Husseinbeygi/CUED-Self-Balancing-Bike/Reports/Final Report/sections/Introduction.tex

\begin{figure}[H]
	\centering
    \def\svgwidth{0.9\textwidth}
    \input{./figures/bikeevo.pdf_tex}
    \caption{Bicycle Evolution (adapted from \cite{bikeevo})}
	\label{fig:bikeevo}
\end{figure}

Bicycles and their stability properties have been studied for well over a century, most notably by academics such as Whipple (1899, \cite{whipple}), Papadopoulos (1980s onwards, \cite{papadopoulos}), and {\AA}str{\"o}m (2005, \cite{astrom}). The bicycle is a naturally unstable system but can be self-stable under certain conditions. It is however still commonly unclear what primarily contributes to this self-stability. The full form of the equations of motion do not aid the intuitive understanding of bicycle stability and dynamics, as they are a set of coupled and highly non-linear differential equations. \\

\noindent In addition to simply understanding the causes of self-stability , there are further considerations to studying a bicycle in the frameworks of dynamics and control theory. For example, how does a human stabilise a bicycle and is it possible to replicate this behaviour with motors? What makes a bike more or less stable - for instance, changes in geometry, mass distribution, or wheel size? And would there be a benefit in having an assisted bicycle for certain people in certain situations? \\

\noindent This project aims to answer - at least in part - some of these questions. In addition, this project explores the modelling, simulation, control system design, and implementation of two rider-less, self-balancing bicycles. \\

The first bicycle was chosen to be a \textit{Lego Mindstorms} prototype and the second one a full-scale, adult bicycle. Both bicycles are depicted in Figures \ref{fig:lego} and \ref{fig:fs} below in their final, modified forms. These bicycles however only have a drive actuator, to provide forward velocity, and an actuator placed at the handlebars to provide a \textit{steer} torque. Without the additional component of being able to provide a \textit{lean} torque, it is extremely difficult to guarantee stability at near-zero forward speed, as will be shown in this report. The bicycles being studied in this case can therefore be classed as \textit{underactuated systems}.

\vfill

\begin{figure}[h]
\centering

\caption{Lego Prototype Bicycle}
\label{fig:lego}
\end{figure}

\begin{figure}[h]
\centering

\caption{Full-Scale Bicycle}
\label{fig:fs}
\end{figure}

\newpage
