Husseinbeygi/CUED-Self-Balancing-Bike/Reports/Scribble.pdf

# Self-Balancing Bicycle

## Final Project

Philip Salmony
Wolfson College
pms67@cam.ac.uk

Supervisor: Dr. Fulvio Forni

4 September 2018

## Summary

Modelling, analysis, simulation, and implementation of an autonomous, self-balancing bicycle.

## Contents

1 Introduction and Objectives | 3
2 Notation | 3
3 Bicycle Modelling | 3
4 Equations of Motion | 5
5 Controller Design | 8
6 Trajectory Tracking | 12
7 Simulation | 12
8 Implementation | 12
9 Results and Discussion | 13
10 Conclusions | 13
11 References | 13
12 Appendix | 13

## 1 Introduction and Objectives

1. Autonomous self-balancing at close-to-zero forward velocity and above.
2. Robustness to modelling inaccuracies as well as to mass and geometry changes.
3. Trajectory tracking.

## 2 Notation

Coordinate systems, notation(e.g. mrf , Ixx, etc..)

## 3 Bicycle Modelling


Figure 1: Simplified Bike Model and Coordinate System

### 3.1 Mass and Center of Mass

The purchased bike was disassembled and the masses of both wheels and the remaining frame measured using a luggage scale. To estimate the masses of the rear and front frames, the dimensions of each connecting tube of the frames was measured to approximate their respective volumes. As mass is proportional to volume, this enabled an estimate of the individual masses of the tubes. Summing the tubes belonging to the appropriate frame gave an approximation of the mass of that frame. The results are as follows:

- mrf = 7.8kg
- mf f = 2.1kg
- mrw = 3.1kg
- mfw = 2.5kg

Rear Frame
(x, y, z)rf = [0.507, 0.000, −0.534]

Front Frame
(x, y, z)f f = [0.960, 0.000, −0.597]

Rear Wheel
(x, y, z)rw = [0.000, 0.000, −0.320]

Front Wheel
(x, y, z)f f = [1.080, 0.000, −0.320]

### 3.2 Inertia Tensor

The moment of inertia tensor describes the resistance to rotational motion of a three-dimensional object around certain axes about its center of mass. It is defined as follows,

I =

Ixx Ixy Ixz
Iyx Iyy | Iyz
Izx Izy | Izz

We make the simplifying assumption that the terms Ixz, Izx, Iyz, Izy are zero. The defini-tions for the remaining terms are,

Ixx =

Z
(y

2 + z

2
)dm

Iyy =

Z
(x

2 + z

2
)dm

Izz = Ixx + Iyy

Ixy = Iyx = −

Z
(x · y)dm

Rear Frame

Irf =

0.206 | 0 | 0.164
0 | 0.643 | 0
0.164 | 0 | 0.444

Front Frame

Iff =

0.061 | 0 | −0.017
0 | 0.059 | 0
−0.017 | 0 | 0.013

Rear Wheel

Irw =

0.159 | 0 | 0
0 | 0.317 | 0
0 | 0 | 0.159

Front Wheel

Ifw =

0.128 | 0 | 0
0 | 0.256 | 0
0 | 0 | 0.128

### 3.3 Overall Description

Total System

Mass and Center of Mass

mt = mrw + mrf + mf f + mfw = 15.5 | (1)

xt =

1
mt
(xrfmrf + xf fmf f + wmfw) = 0.559 | (2)

zt =

1
mt
(−Rrwmrw + zrfmrf + zf fmf f − Rfwmfw) = −0.465 | (3)

Moments and Products of Inertia

Txx = Axx + Bxx + Cxx + Dxx + mrwR

2
rw + mrf z

2
rf + mf f z

2
f f + mfwR

2
fw = 4.10 | (4)
Txz = Bxz + Cxz − mrfxrf zrf − mf fxf f zf f + mfwwRfw = 4.33 | (5)

Tzz = Azz + Bzz + Czz + Dzz + mrfx

2
rf + mf fx

2
f f + mfww
2 = 7.60 | (6)

Front Frame

Mass and Center of Mass

mf = mf f + mfw = 4.6 | (7)

xf =

1
mf
(xf fmf f + wmfw) = 1.025 | (8)

zf =

1
mf
(zf fmf f − Rfwmfw) = −0.446 | (9)

Moments and Products of Inertia

Fxx = Cxx + Dxx + mf f (zf f − zf )

2 + mfw(Rfw + zf )

2 = 0.277 | (10)
Fxz = Cxz − mf f (xf f − xf )(zf f − zf ) + mfw(w − xf )(Rfw + zf ) = −0.0549 | (11)

Fzz = Czz + Dzz + mf f (xf f − xf )

2 + mfw(w − xf )

2 = 0.157 | (12)

Miscellaneous

λ =

π
2

− α =

π
9

(13)

u = (xf − w − t) · cos(λ) − zf · sin(λ) = 0.021 | (14)

Sr =

Ayy

Rrw

= 0.991, Sf =

Dyy
Rfw
= 0.800, St = Sr + Sf = 1.79 | (15)

## 4 Equations of Motion

### 4.1 Second Order Model

### 4.1.1 Excluding Fork Dynamics

Simplified tilt equation:

¨θ =

Mgl
J

sin(θ) + Ml
J

v

2
r
b

tan(φ) + a
b

d(vtan(φ))
dt
cos(θ) | (16)

For near-upright motion with constant velocity v: ˙v = 0, sin(θ) ≈ θ, tan(φ) ≈ φ, and cos(θ) ≈ 1. We can therefore linearise the equation as follows:

¨θ =

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
(17)

Defining γ =

M l
Jb :

¨θ = bgγθ + γ(v
2

rφ + avφ˙)

Taking Laplace transforms:

s

2 ¯θ = bgγ ¯θ + γ(v
2

rφ¯ + savφ¯)

¯θ(s

2 − bgγ) = φγv ¯ (sa + v)

Which results in the transfer function G(s) from steer angle φ to lean angle θ:

G(s) = γva

(s +

v
a

)
(s

2 − bgγ)

(18)

We can extract three bits of information:

1. Gain: k =

M lva
Jb
2. Zero: z = −

v
a
3. Poles: p1,2 = ±

q
M lg
J

The gain tells us that as our forward velocity v goes to zero, turning the forks will not influence the tilt angle.
The zero tells us that this is a minimum phase system.
The poles tell us that this system is unstable and non-oscillatory.

For the prototype bicycle the transfer function becomes,

G(s) = 0.491 · v ·

(s +

v
0.559 )
(s
2 − 9.30). | (19)

### 4.1.2 Including Fork Dynamics

Shows stability for large enough forward speed...

### 4.2 Fourth Order Model

A model found in many research papers, is the fourth order linearised model consisting of two coupled second order differential equations. This model can be written in the following matrix form:

M · q¨+ [C1 · v] · q˙ + [K0 + K2 · v

2
] · q = f | (20)

Where q = [φ, δ]

T
is a vector containing the lean angle (φ) and the steer angle (δ), f = [Tφ, Tδ]

T
is a vector consisting of a roll torque disturbance and handlebar torque, and finally the system matrices, which are derived from the bicycle geometry:
1. M - Mass matrix
2. C1 - Damping matrix, varying linearly with velocity
3. K0 and K2 - Stiffness matrices, varying quadratically with velocity

The elements of each matrix are as follows:

M =

Txx | Fλx + fTxz
Fλx + fTxz | Fλλ + 2fFλz + f

2Tzz
(21)

C1 =

"
0 | fSt + Sf cos(λ) + Txz

cos(λ)
w | − fmtzt
−(fSt + Sf cos(λ)) | Fλz

λ
w + f(Su + Tzz

cos(λ)
w
(22)

K0 =

gmtzt | −gSu
−gSu | −gSusin(λ)
(23)

K2 =

"
0 (St − mtzt)

cos(λ)
w
0 (Su + Sf sin(λ)) cos(λ)
w
(24)

### 4.2.1 Decoupling and Transfer Functions

Taking Laplace Transforms, assuming zero initial conditions:

s

2
- M · q¯+ s · [C1 · v] · q¯+ [K0 + K2 · v

2

] · q¯ = ¯f

Rearranging into transfer function form yields:

G(s) =
s

2
- M + s · C1 · v + (K0 + K2 · v

2
)

−1
(25)

Since K211 = K221 = C111 = 0, the determinant of G(s) is

det(G(s)) = P(s) = s

4
- (M11M22 − M12M21)

+ s

3
- v · (M11C122 − (M12C121 + M21C112 )

+ s

2
- (M11K022 + M22K011 − M21K012 − M12K021 ) + v

2
- (M11K222 − M21K212 − C112C121 ))

+ s · v · (K011C122 − K021C112 − K012C121 − v

2
- K212C121 )

+ (K011K022 − K021K012 ) + v

2
- (K011K222 − K021K212 ).

Where the roots of P(s) are equal to the poles of the system.

As can be seen from the long expression above, it is hard to directly see what parameters in the bicycle’s geometry - or the forward speed - influence the stability. This is especially true, since this is a linearised model of a much more complex system!

Continuing with the evaluation of the matrix inverse, we get a set of four decoupled transfer functions relating the roll and steer torque inputs to the roll and steer angular outputs:

(i) Roll Torque Disturbance to Lean Angle

G11(s) = m22 · s

2 + v · C122 · s + (K022 + K222 · v

2
)
P(s)

(ii) Roll Torque Disturbance to Steer Angle

G12(s) = −

m12 · s

2 + v · C112 · s + (K012 + K212 · v

2
)
P(s)

(iii) Handlebar Torque to Lean Angle

G21(s) = −

m21 · s

2 + v · C121 · s + K021
P(s)

(iv) Handlebar Torque to Steer Angle

G22(s) = m11 · s

2 + K011
P(s)

Again, it is hard to see how the bicycle parameters influence the positions of the systems zeros.

For the prototype bicycle the poles P(s) are then given by,

P(s) = 0.711s

4 + 1.30vs³ + s

2
(−22.3 + 5.01v

2
) + sv(−21.4 + 6.93v

2
) + (123 − 5.54v

2
) (26)

Which leads to following the set of transfer functions:

(i) Roll Torque Disturbance to Lean Angle

G11(s) = 0.214 · s

2 + v · 0.744 · s + (−2.48 + 0.881 · v

2
)
P(s)

(27)

(ii) Roll Torque Disturbance to Steer Angle

G12(s) = −

0.407 · s

2 + v · 5.18 · s + (−7.25 + 7.83 · v

2
)
P(s)

(28)

(iii) Handlebar Torque to Lean Angle

G21(s) = −

0.407 · s

2 − 0.884 · v · s − 7.25
P(s)

(29)

(iv) Handlebar Torque to Steer Angle

G22(s) = 4.10 · s

2 − 70.7
P(s)

(30)

### 4.3 State Space Form

Choosing states as x =

φ δ φ˙ ˙δ

T
and inputs as u =
Tφ Tδ

T
, we arrive at the
following state space model for our prototype bicycyle (assuming all our states are measur-able):

x˙ = Ax + Bu
y = Cx

With the system matrices being,

A =

0 | 0 | 1 | 0
0 | 0 | 0 | 1
17.1 0.761 − 1.85v

2 −0.506v −1.13v
1.36 10.2 − 0.602v
2 | 5.10v | −1.32v

B =

0 | 0
0 | 0
0.300 | −0.572
−0.572 | 5.77

C =

1 0 0 0
0 1 0 0
0 0 1 0
0 0 0 1

(31)

## 5 Controller Design

What can we actuate? What sensor do we have? Controllability/Observability

### 5.1 Stability Analysis

### 5.1.1 Dependence on Forward Speed

Three controller regimes.

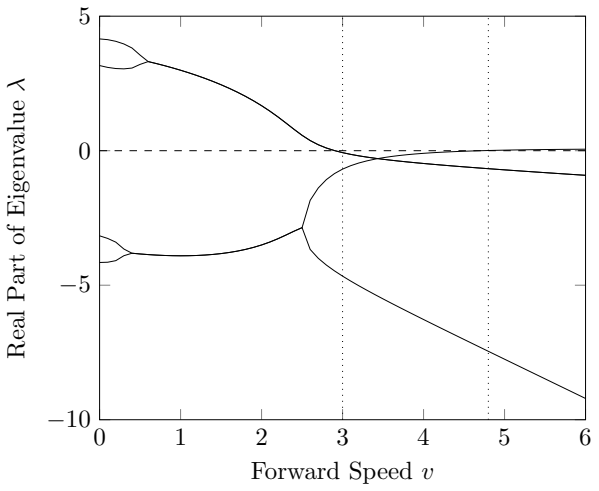
[picture p13: figure]
Forward Speed v; Real Part of Eigenvalue

Figure 2: Pole Locations vs Forward Speed

### 5.2 Single Input Single Output (SISO)

CURRENTLY EXCLUDING FORK DYNAMICS - WILL CHANGE Which transfer function model do we use? Second order, fourth order, or both? BOTH

### 5.2.1 Proportional Controller

Kp | G(s) r¯ | e¯ | u¯ | y¯

y¯m

Figure 3: P Controller Structure

Transfer Function
Plotting the root locus diagram for the tilt transfer function, we can see that a simple proportional controller (K(s) = Kp) in a standard negative feedback configuration can stabilise this plant. The closed-loop transfer function P(s) is of the following form:

P(s) = Kp · (γva) ·

(s +

v
a

)
s

2 + (γva)Kps + γ(v

2
rKp − bg)

(32)

Using the following root locus relationship to find the required proportional gain:

Kp =

1
|G(s)|

(33)

We are concerned with finding the minimum proportional gain that will guarantee closed-loop stability, therefore we wish to find a gain that will give us s < 0. Therefore, at s = 0, Kp =

bg
v

2
r

, which is the proportional gain needed for marginal stability. We require a gain larger than this to ensure asymptotic stability.

The furthest left we can go in the s-plane by increasing Kp is when our closed-loop pole meets the open-loop zero at v
a

, which gives an exponential decay time constant of a
v

Prototype Bicycle
For the prototype bicycle, the closed-loop transfer function with a proportional controller becomes,

P(s) = 0.491 · Kp · v ·

(s +

v
0.559 )
s

2 + 0.491 · Kp · v · s + 0.878 · (v

2Kp − 10.6). | (34)

From above, we require a minimum proportional gain of Kp =

bg
v

2 =

10.6
v

2 for stability.

### 5.2.2 P-D Controller

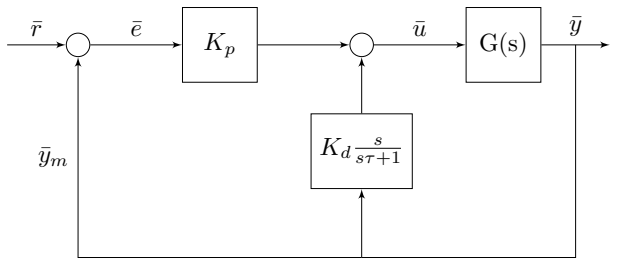
[picture p14: figure]

Figure 4: P-D Controller Structure

Derivative on measurement to avoid derivative kick when setpoint changes.

Derivative on Measurement
e = r - y
u = Kp * e - Kd * s / (sT + 1) * y y = G * u

Band-Limited Differentiator
Since a pure differentiator acts as an amplifier for high frequencies, it will also amplify any high-frequency noise present in the measured plant output. Additionally, for a low sample time, this amplification increases by 1
T

. This will result in extreme jittering of the actuator, drastically reducing its lifespan and the overall control performance. Furthermore, we cannot calculate the exact derivative at time t. We need to approximate it numerically, for example, using Euler’s backward difference method.
To address these problems, instead of implementing a pure derivative controller with transfer function s, we utilize a band-limited differentiator. This is effectively a pure differentiator cascaded with a single-pole low-pass filter,

D(s) = Kd

s
sτ + 1
, | τ > 0. | (35)

Where Kd is the associated derivative gain and τ is the filter time constant. The cut-off frequency (in rads⁻¹
) of the low-pass filter is therefore 1
| τ

. The closer τ is to zero, the closer our approximation is to the actual derivative. However, we will also greatly increase our noise since this is inversely proportional to the cut-off frequency of the filter.

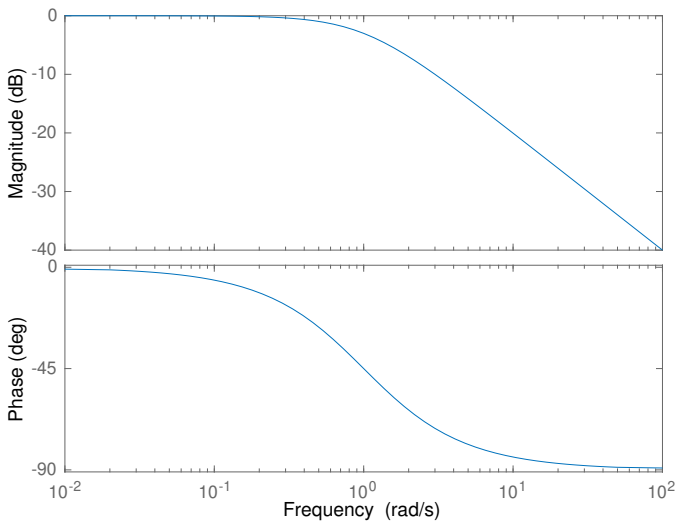
[picture p15: figure]
Magnitude (dB); Phase (deg); Frequency (rad/s)

Figure 5: Bode Diagram of Band-Limited Differentiator (τ = 1)

Transfer Function
The closed-loop transfer function of the P-D controller in combination with a general plant G(s) is thus,
H(s) = | Kp · G(s) 1 + G(s) · (Kp + Kd

s
sτ+1 )

Replacing G(s) with the transfer function of the linearised second order bicycle model, we arrive at the following closed-loop transfer function:

H(s) = Kp · γva · | (s +

v
a

)
s

2 − bgγ + γva · (s +

v
a

) · (Kp + Kd

s
sτ+1 )

(36)

Where the transfer function can be further expanded by multiplying the numerator and denominator by (sτ + 1) to yield,

H(s) = Kp·γva·

(s +

v
a

)(s +

1
τ

)
s

3 + s

2 1
τ

(1 + γvaKpτ + Kd) + s

γ
τ

(Kpv(a + vτ ) + Kdv

2 − bgτ ) + γ
τ

(v

2Kp − bg)

For analysis and control design purposes, this equation is too complex. We therefore simplify the transfer function by assuming we filter the sensor measurements with the low-pass filter (LP(s) = 1 sτ+1 ) before feeding them into the derivative-part of the controller. Therefore,
we can assume a pure differentiator. This results in the simplified closed-loop, second order transfer function:

H∗
(s) = Kp · γva ·

(s +

v
a

)
s

2(1 + Kdγva) + sγv(aKp + vKd) + γ(v

2Kp − bg)

=

Kpγva
1 + Kdγva

·

(s +

v
a

)

s

2 + s

γv(aKp+vKd)
1+Kdγva +

γ(v

2Kp−bg)
1+Kdγva
Pole Placement
We need to place two poles for the closed-loop system (p1 and p2). The second-order characteristic equation is therefore,

C(s) = (s − p1)(s − p2) = s

2 − (p1 + p2)s + p1p2

To get the the controller gains Kp and Kd we equate the coefficients of the transform variable s of the closed-loop transfer function’s denominator with those of the characteristic equation:

γv(aKp + vKd)
1 + Kdγva
= −(p1 + p2) | (37)

γ(v

2Kp − bg)
1 + Kdγva
= p1p2 | (38)

After rearranging, we arrive at the following matrix set of linear relationships for Kp and Kd:
γv² | −γvap1p2
γva γv(v + (p1 + p2)a)

Kp
Kd
=
p1p2 + γbg
−(p1 + p2)
(39)

These can then be easily solved to give Kp and Kd, so that:
Kp
Kd
=

1
γ

2v

2(v(v + (p1 + p2)a) + a

2p1p2)

γv(v + (p1 + p2)a) γvap1p2
−γva | γv²

p1p2 + γbg
−(p1 + p2)

### 5.3 State Feedback

Pole placement - do not want to drastically change system dynamics - essentially only want to provide stability (all real parts of eigenvalues must be negative). Can push poles further left in the s-plane to increase stability margins, especially since plant is modelled only ap-proximately so will contain variations. Must watch that we do not hit the actuator limits by choosing poles magnitudes too large.
Gain-scheduled state feedback depending on forward velocity. Lookup tables, since comput-ing poles is too resource intensive for microcontroller.

### 5.4 Optimal Control

### 5.5 Zero-Speed Stabilisation

## 6 Trajectory Tracking

## 7 Simulation

### 7.1 MatLAB

### 7.2 Unity

## 8 Implementation

Bike, Sensors, Actuators, System as a whole, Arduino, processing (LP Filter), complemen-tary filter, kalman filter, IMU, post-processing (C#/Python?), MatLAB, etc.

## 9 Results and Discussion

## 10 Conclusions

## 11 References

## 12 Appendix
