Husseinbeygi/CUED-Self-Balancing-Bike/Reports/Final Report/FinalReport.pdf

# Self-Balancing Bicycle

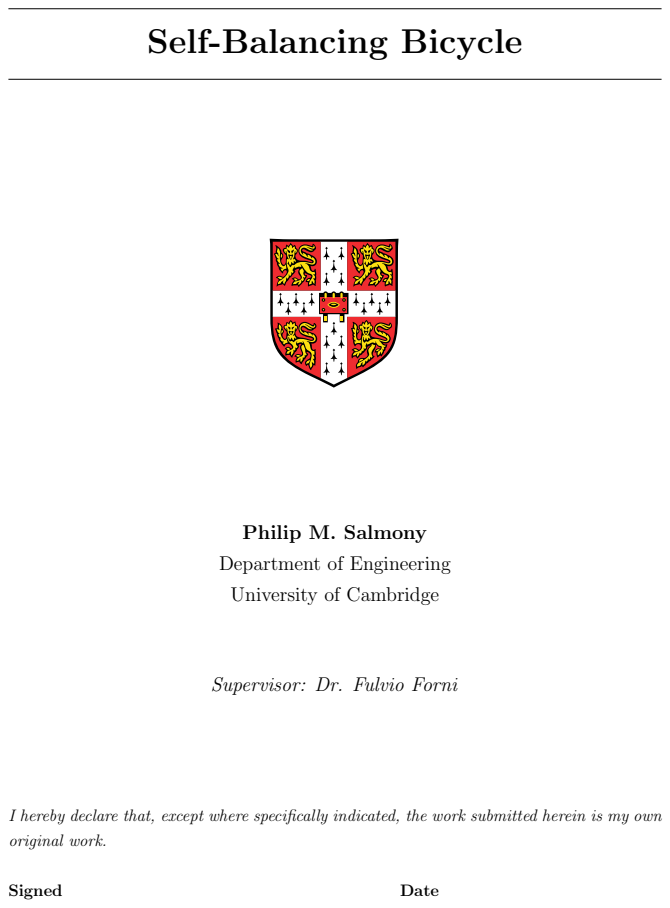
[picture p16: page 1]
Signed; Date

Philip M. Salmony
Department of Engineering
University of Cambridge

Supervisor: Dr. Fulvio Forni

I hereby declare that, except where specifically indicated, the work submitted herein is my own
original work.

## Self-Balancing Bicycle

### Philip Salmony, Wolfson College

### Abstract

## Contents

1 Introduction | 3
2 Modelling | 4
3 Controller Design and Simulation | 16
4 Implementation: Lego Prototype | 29

1

5 Implementation: Full-Scale Bicycle | 34
6 Conclusions and Future Work | 37
References | 37
Appendix A Risk Assessment | 38

2

1 INTRODUCTION | 3

## 1 Introduction

This project involves the modelling, simulation, control system design, and implementation of a rider-less, self-balancing bicycle. Bicycles and their stability properties have been studied for well over a century, most notably by academics such as Whipple (1899, [1]), Papadopoulos (1980s onwards, [2]), and Astrom (2005, [3]). Most individuals know that a bicycle can

be self-stable under certain conditions but it is still commonly unclear what primarily contributes to this self-stability. The full form of the equations of motion do not aid the intuitive understanding of bicycle stability and dynamics, as they are a set of coupled and highly nonlinear differential equations. Thus, simplifying assumptions must be sought out.

In addition to simply understanding the causes of self-stability of a bicycle, there are further considerations to studying a bicycle in the frameworks of dynamics and control theory. For example, how does a human stabilise a bicycle and is it possible to replicate this behaviour with motors? What makes a bike more or less stable (for instance, changes in geometry, mass distribution, or wheel size - to name a few)? And would there be a benefit in having

an assisted bicycle for certain people in certain situations?

This project therefore aims to try and answer - at least in part - some of these questions, with a primary focus on designing suitable control systems that achieve closed-loop stability over a large range of forward velocities.

Finally, the report details the implementation of the designed control laws for two rider-less bicycles. Firstly, a Lego Mindstorms prototype and secondly a full-scale, adult bicycle. Both bicycles are depicted in Figures 1 and 2 below. These bicycles however only have a drive actuator, to provide forward velocity, and an actuator placed at the handlebars to provide a steer torque. Without the additional component of being able to provide a lean torque, it is extremely difficult to guarantee stability at near-zero forward speed, as will be shown in this report. The bicycles being studied in this case can therefore be classed as underactuated systems.

2 MODELLING | 4


Figure 1: Lego Prototype Bicycle

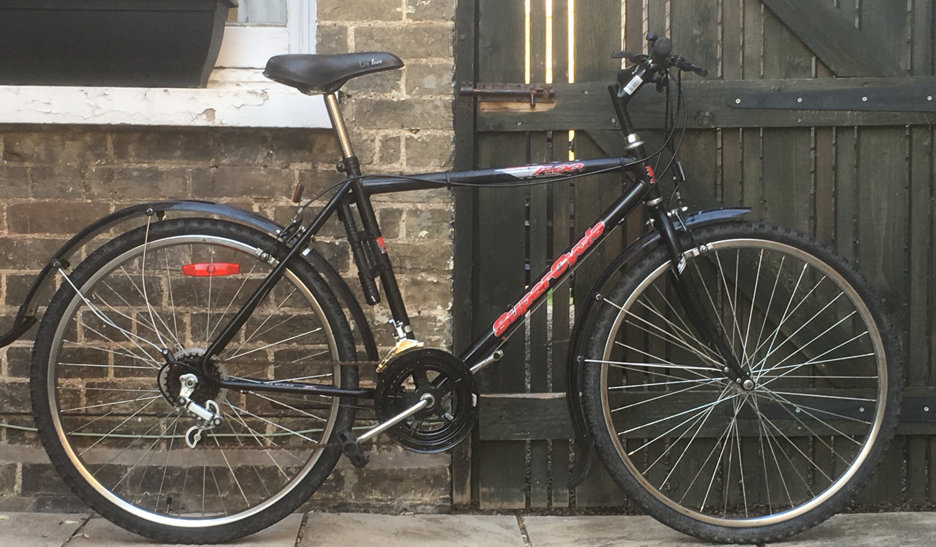
[picture p17: figure]

Figure 2: Full-Scale Bicycle

## 2 Modelling

To be able to design suitable control laws in order to stabilise the bicycle, it is necessary to provide a mathematical description of the system. Additionally, developing a dynamical model of the system will give an insight into what factors influence a bicycle’s behaviour in terms of its stability.

As previously mentioned, the equations of motion for a bicycle are a set of many, highly non-linear, and coupled differential equations. In this form, they do not aid an intuitive understanding of what makes a bicycle more or less stable and are inconvenient to use for control law design, which is based mainly on linear methods. For simulation however, these

2 MODELLING | 5

non-linear equations of motion are important, as they capture the dynamics over the entire range of operating regimes.

This section aims to explore two commonly used linearised bicycle models of second and fourth order, which will be the basis for controller design in later sections.

### 2.1 Geometry and Definitions

The definitions of bicycle parameters, geometry, and coordinate system in this report follows the system given by ˚Astr¨om in [3], which is based on the ISO 8855 standard [4]. A brief

explanation of the bicycle parameters, as well as the top, rear, and side views of the bicycle are detailed in Table 1 and Figures 3 and 4.

Parameter | Symbol Description
Center of Mass (z) | h | Distance of center of mass from ground.
Center of Mass (x) | a | Distance of center of mass from center of rear wheel.
Wheel Base | b | Distance between centers of both wheels.
Trail | c | Distance between intersection of steering axis with
| | ground and point of contact with ground of front wheel.
Head Angle | λ | Angle between steering axis and ground.

Table 1: Bicycle Parameter Definitions

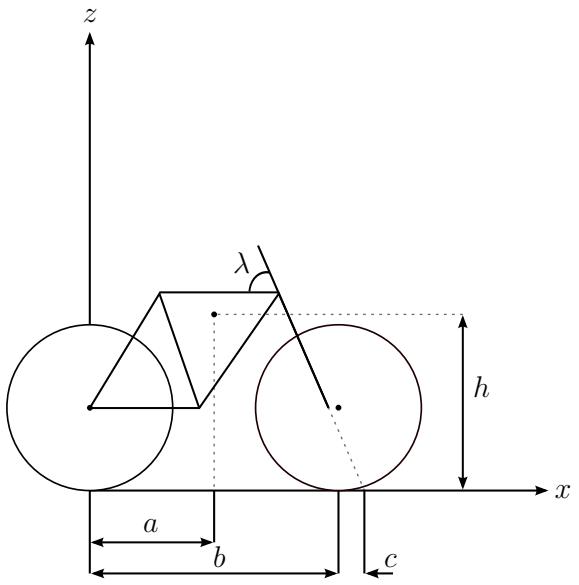
[picture p18: figure]

Figure 3: Side View

2 MODELLING | 6

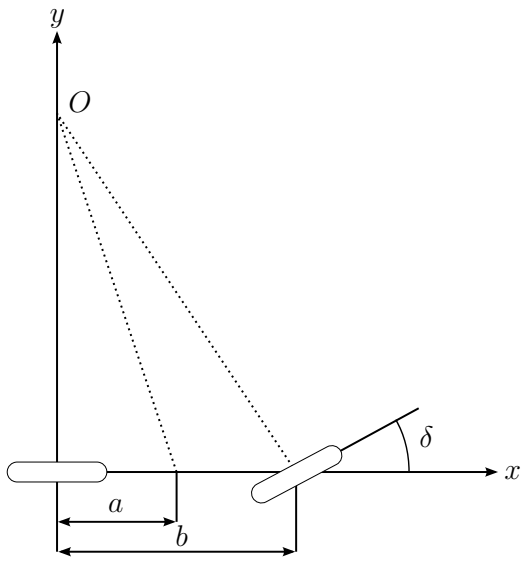
[picture p19: figure]

(a) Top View

z

φ

y

(b) Rear View

Figure 4: Geometric Definitions

### 2.2 Parameter Estimation

The parameters of the real-world bicycles needed to be estimated to be used in the models explored in this section.

The required lengths were obtained by simple measurement. However, parameters such as centers of mass, as well as moments of inertia were more difficult to estimate. To aid the estimation, a Python script was written that takes as an input the geometry and mass distribution of the bicycle, slices this geometry into a finite three-dimensional grid, and then computes the center of mass and moment of inertia terms via discrete approximations of the relevant integrals.

The estimated parameters for both bicycles can be found in Table 2 below.

2 MODELLING | 7
Parameter | Symbol | Lego | Full-Scale
Mass | m | 0.76kg | 28kg
Center of Mass (x) | a | 0.10m | 0.26m
Center of Mass (z) | h | 0.11m | 0.55m
Wheel Base | b | 0.23m | 1.1m
Moment of Inertia (xz) | Ixz | 0.0084kg m² | 8.3kg m²
Moment of Inertia (x) | Ix | 0.0092kg m² | 3.9kg m²

Table 2: Lego Prototype and Full-Scale Bicycle Estimated Parameters

### 2.3 Second Order Model

The simplest model of a bicycle leads to a second order differential equation relating the steer angle δ to the lean angle φ. It does not take the dynamics of the front fork into account and assumes zero trail c, a 90◦ head angle λ, and a constant forward speed V .

Even though the model is limited due to its simplifying assumptions, it provides useful and intuitive insights into aspects of bicycle stability. In addition, it forms the basis for controller design in later sections.

### 2.3.1 Derivation

The derivation given in this section follows the method used by ˚Astr¨om in [3]. The first step

in deriving the second order model is to consider a bicycle that is rotating about a fixed center O with angular velocity ωz. Using the method of instantaneous centers, this can be calculated to be
ωz =

V
b

tan (δ).

Then, computing the angular momentum of the system:

L = I · ω =

Ix | 0 Ixz
0 | Iy | 0
Ixz | 0 | Iz

φ˙

0
ωz

Extracting only the component about the x-axis and letting D = −Ixz and J = Ix gives

Lx = Jφ˙ − D

V
b

tan (δ).

2 MODELLING | 8

Taking derivatives, whilst noting that a constant forward speed is assumed, leads to

L˙

x = Jφ¨ −

D
b

V ˙δ sec²
(δ).

Now the torques acting on the system are required, which can be summed and used in conjunction with Newton’s second law for moments,

L˙
x =

X

N

i=1

τi

In this model, it is assumed that two torques are acting on the system. The first being due to gravity and a non-zero lean angle,

τg = mgh sin (φ).

The second torque is due to circular motion and can be written as follows:

Fc = mω²
z

r =

mV ²
b

tan (δ)

τc = Fch cos (φ)

=

mV ²h
b

tan (δ) cos (φ)

Summing both torques results in the final moment balance:

Jφ¨ −

V D
b

˙δ sec²

(δ) = mgh sin (φ) + mV ²h
b
tan (δ) cos (φ) | (1)

This is the final form of the governing second-order, non-linear differential equation of motion and will be used for simulation. To make this model useful for controller design, it needs to be linearised about zero lean and zero steer angle by using small-angle approximations. Collecting terms, the linearised equation of motion then becomes,

Jφ¨ − mghφ =

V D
b

˙δ +

mV ²h
b

δ.

Now taking Laplace transforms, the transfer function for the second order bicycle model becomes:
G(s) = φ¯(s)
¯δ(s)

=

V D
Jb

s + mhV/D
s

2 − mgh/J

Lastly, the moment of inertia terms can be approximated as D ≈ mah and J ≈ mh² | , which

2 MODELLING | 9

leads to the final version of the linearised, second order model,

G(s) = V a
hb

s + V/a
s
2 − g/h. | (2)

This transfer function, relating the steering angle δ (in degrees) to the lean angle φ (in degrees), will be used as the basis for controller design and is strongly dependent on forward

speed V . It is composed of a variable gain, variable left-half plane zero, and a fixed pair of symmetric real poles with one in the left-half plane and one in the right-half plane. Notice that imposing a steer angle in one direction, will cause the bicycle to lean in the opposite direction. The stability properties of this model can now be investigated.

### 2.3.2 Stability

Even though the model is substantially simplified, it provides a good insight into the stability properties of the bicycle. Four key aspects are as follows:

1. Always unstable: The poles are fixed and do not vary with forward speed. They are always symmetric about the imaginary axis, with one stable and one unstable pole.
2. Speed-dependent gain: The effectiveness of applying a steer angle input decreases as speed decreases. Therefore, controllability of the system decreases as well. Far larger inputs are needed at lower speeds, and smaller inputs are required at higher speeds.
3. Speed-dependent zero: The zero present in the system is moved further into the left-half plane as the forward speed increases. This in effect pulls the root-locus further into the left-half plane as well, making the system easier to stabilise.
4. Center of mass: The poles are located at ±

p
g/h. Since g is fixed, the location of

the center of mass above ground h is the only variable that changes the locations of the poles. Thus, the instability of the bicycle decreases as h increases, with the limiting case of marginal stability when h → ∞. This is analogous to the stabilisation of a

vertical beam: a longer beam is easier to stabilise.

Furthermore, a simple proportional controller of the form δ = −kδφ can stabilise the bicycle

in theory if and only if the gain kδ satisfies the following condition:

kδ >

bg
V

2

(3)

Which shows that an ever-increasing gain is needed as the forward speed decreases. This, of course, is practically infeasible and shows that it is impossible to balance a stationary bicycle

2 MODELLING | 10

via just controlling the handlebars. Interestingly, a longer wheel base (b) in turn requires the

feedback gain to be larger as well.

### 2.3.3 Non-Minimum Phase Behaviour

As a brief aside, the model given above does not take fork parameters into account, such as trail c or head angle λ. Including these in the model leads to a zero that can move into the right-half plane, where the location is given by:

s = −

V

2h − acg
V ah
For a fixed geometry, the zero will enter the right-half plane depending on the forward speed (V < p
acg/h). Thus, the system is not only unstable but also exhibits non-minimum phase

behaviour, making the system extremely difficult to control.

However, since for the Lego prototype the trail c was found to be sufficiently small, it can be effectively ignored, as the model then approximates the simpler minimum phase, second order model derived previously. Furthermore, for the full-scale bicycle the speed is sufficiently large that the zero does not move into the right-half plane. Thus, the simpler second order model can be used for controller design for both bicycles as both do not exhibit non-minimum phase behaviour.

### 2.3.4 Transfer Functions

Using the estimated bicycle parameters for the Lego prototype and full-scale bicycle in conjunction with the second order model, the transfer functions in terms of forward speed can be given for both the Lego prototype and full-scale bicycle.

Lego Prototype

GLego(s) = 3.4 · V ·

s + 10 · V
s

2 − 74

(4)

Full-Scale Bicycle

GF S(s) = 0.44 · V ·

s + 3.8 · V
s

2 − 18

(5)

### 2.4 Fourth Order Model

A natural evolution from the second order model is the fourth order model, which takes the dynamics of the front fork into account. This model can explain why the bicycle can keep itself self-stable under certain conditions. However, the control input is now the torque acting

2 MODELLING | 11

on the handlebar as opposed to the steer angle. Thus, this model is not suited for control design for two reasons:

1. Driving the handlebar motor in torque is not feasible, since both motor current and voltage measurement, as well as knowledge of the internal motor parameters, is needed to estimate the torque.
2. If not most importantly, using a servo at the handlebars essentially eliminates the front fork dynamics by enforcing a steer angle.

Therefore, the second order model will be used for controller design. Nonetheless, this fourth order model is incredibly useful in describing the self-stable dynamics of a rider-less bicycle and will be briefly investigated here. A full derivation is given by Papadopoulos in [5]. The

model takes the following standard form:

M · q¨+ C1 · v · q˙ + (K0 + K2 · v

2
) · q =

"
0
τδ

Where M, C, and K are mass, damping, and stiffness matrices respectively. The vector q is composed of h

φ δiT

Alternatively, this can be converted to a four-state, state-space representation. For the unmodified, full-scale bicycle, this results in the following system matrices:

x˙ =

0 | 0 | 1 | 0
0 | 0 | 0 | 1
17 −0.76 − 1.9v
2 | −0.51v −1.1v
1.4 | 10 − 0.60v
2 | 5.1v | −1.3v

x +

0
0
−0.57

5.8

τδ

Where the state vector is given by x = [φ, φ, δ, ˙ ˙δ]
T

### 2.4.1 Stability

In comparison to the second order model given previously, the fourth order model does not give us a direct insight into factors that make the bicycle more or less stable. However, it does show the fact that when the front fork dynamics are taken into account, the bike will be self-stable across a certain range of forward speeds. In addition, it describes various modes apparent in the bicycle dynamics. This is illustrated in Figure 5 below, which shows the real parts of the eigenvalues of the system dynamics across a range of forward speeds for the full-scale bicycle.

2 MODELLING | 12

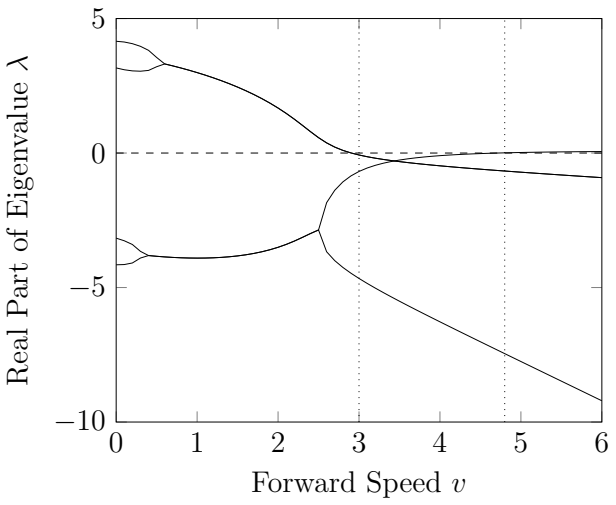
[picture p20: figure]
Forward Speed v; Real Part of Eigenvalue

Figure 5: Pole Locations vs Forward Speed

The plot can be divided into three sections:

1. Unstable and weaving: Up to approximately 3ms⁻¹
, the bike is unstable, as two of the four poles are in the right-half plane. The poles start off as four distinct, real poles and form into two complex-conjugate pairs. These complex poles give rise to an oscillatory, weaving motion, where the frequency of oscillation is dictated by the magnitude of the imaginary components of the poles.
2. Self-stable: From 3ms⁻¹

to roughly 4.8ms⁻¹
, the bike is self-stable with all poles in the left-half plane. This stability is due to the fact that as the bicycle leans over the fork is now able to steer into the direction of the fall due to its geometry, thus catching the bike from from falling down further and restoring it to an upright position.
3. Capsize: Contrary to popular belief, increasing the speed does not improve stability indefinitely. After 4.8ms⁻¹
, a real pole again moves into the right-half plane. However, this pole is very slow and thus the system is easier to stabilise via feedback compared to slower speeds. This mode is commonly termed the capsize mode.

The weave and capsize modes can be excited by a lean torque disturbance when the bicycle is travelling at the relevant forward speed. This is shown in Figure 6 below for the full-scale bicycle model.

2 MODELLING | 13

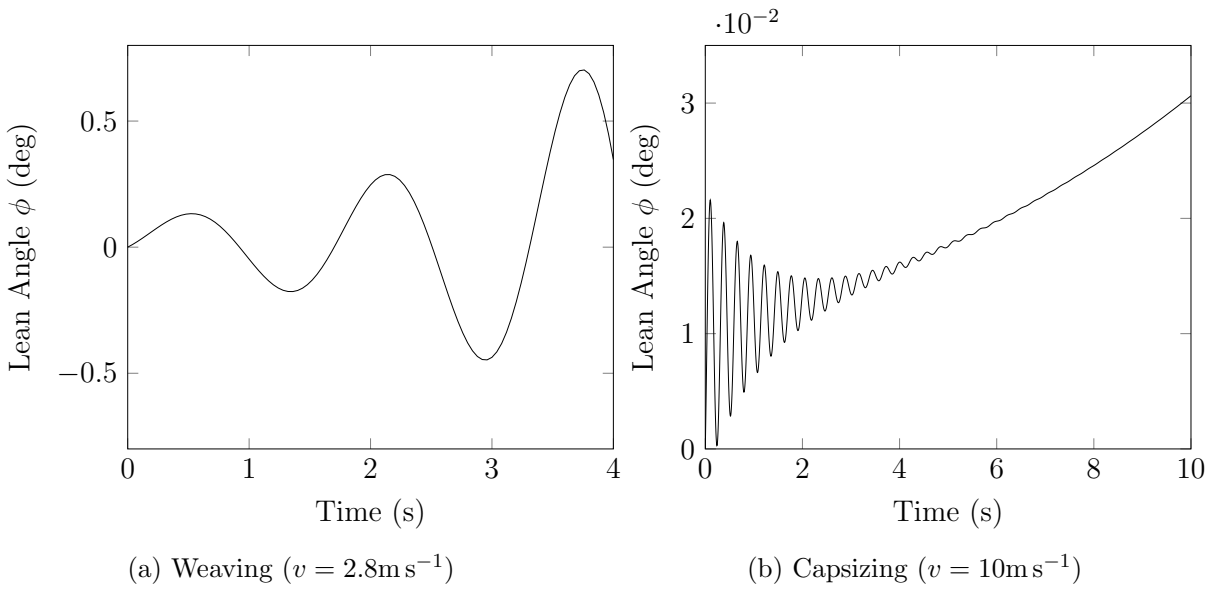
[picture p21: figure]
Time (s); Lean Angle; φ (deg); (b) Capsizing (v = 10m s⁻¹

(a) Weaving (v = 2.8m s⁻¹

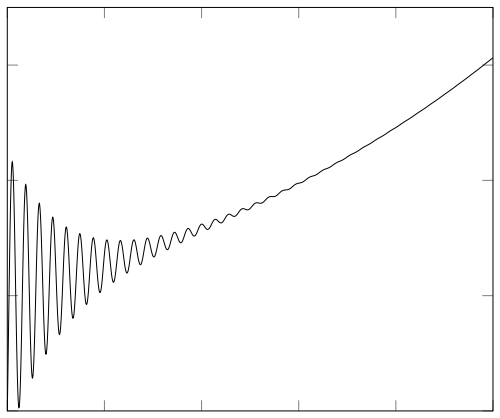
[picture p22: figure]

Figure 6: Modes of Full-Scale Bicycle

The oscillations of the unstable weave mode dominate the response in a). On the other hand in b), the high frequency oscillations due to the stable complex-conjugate poles die out

quickly with the very slow, non-oscillatory capsize mode dominating the response and finally causing the bicycle to fall over. Notice that even after ten seconds, the lean angle has only deviated by a couple hundredths of a degree. As stated before, this mode is therefore very easily stabilised.

### 2.5 Actuators

The modelling of control actuators is also of vital importance and needs to be included in the overall system representation. This is due to the fact that actuators cannot change their position instantaneously and therefore will introduce lag into the system, which may cause further instability.

The actuator models were identified by applying a step input to the handlebar servos and recording the corresponding output response. It is important to mention that the step responses were under loaded conditions, meaning that the servos were mounted on the front forks, supporting the full weight of the bicycle.

An initial guess was made at the form of the transfer function, such as the model order and form. Then, the Matlab System Identification Toolbox was used to identify the locations of

2 MODELLING | 14

the poles and zeros, as well as the magnitude of any possible delays.

### 2.5.1 Lego Prototype

Interfacing with the Lego handlebar motor can only be achieved by issuing a speed command, not an absolute position command. This meant that it was necessary to implement an additional controller to set the motor position. Luckily, an encoder was already fitted to the servo, meaning that positional measurement for feedback was available. After experimentation, it was decided to use a proportional-only controller, since it satisfied the requirements and was easy to implement. The step responses for a set of proportional gains can be seen in Figure 7 a) below. A proportional gain of 2 was chosen to give a critically damped response, with

a fast rise time, and minimal steady-state error.

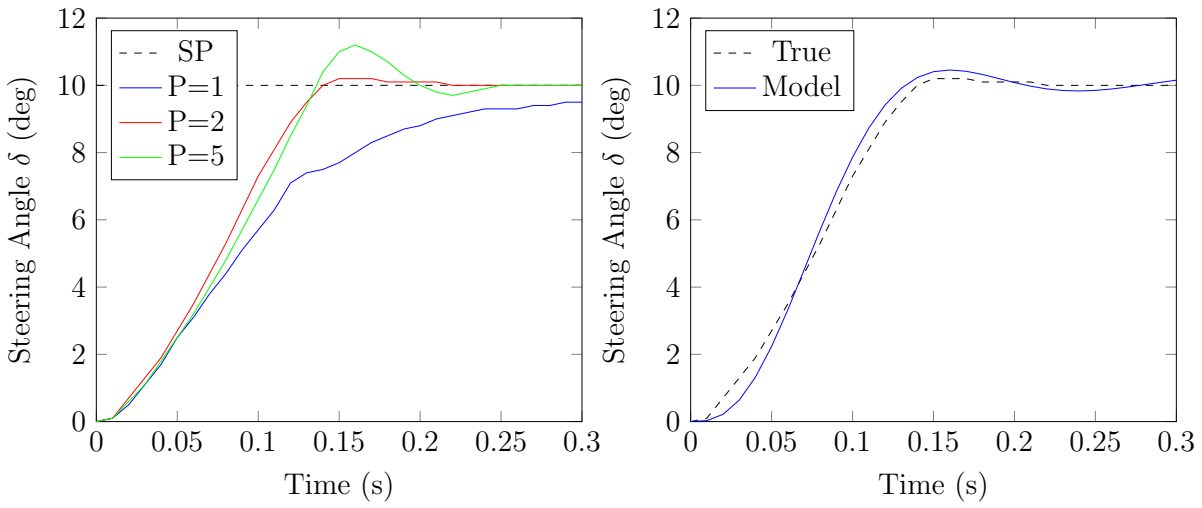
[picture p23: figure]
Time (s); Steering Angle; δ (deg); True Model

(a) True Servo Responses

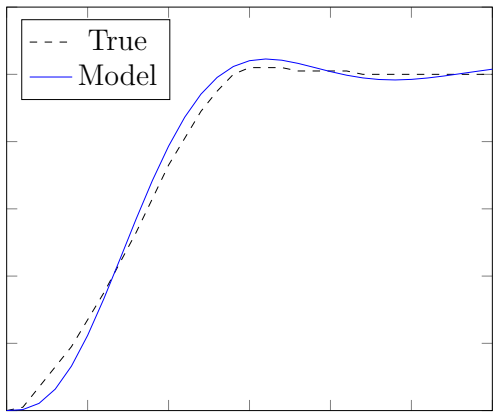
[picture p24: figure]

(b) Model Verification (P=2)

Figure 7: Lego Prototype Servo Responses

The closed-loop, proportional-control motor system was given a step input of magnitude 100 degrees. The System Identification Toolbox was then used to fit transfer function parameters to the acquired step response data. By iteration, a third order model, consisting of a real pole and an under-damped pair of poles, of the following form was chosen:

Ga(s) = | 1
(T1s + 1) · (T

2
ws
2 + 2ζTws + 1) | (6)

Where T1 = 0.056, Tw = 0.030, and ζ = 0.37. The identification algorithm suggested a near 95% match between true data and simulated data from this third order model. A comparison

2 MODELLING | 15

between the true and model step responses, visually confirming a good agreement, can be seen in Figure 7 b).

This servo model is then cascaded with the bicycle model to give an overall more accurate representation of the real-world system.

### 2.5.2 Full-Scale Bicycle

The same process can now be repeated for the full-scale bicycle. However, direct positional control of the motor was already implemented by the manufacturer and thus the step response data could be directly acquired.
Again, a third order model was fitted to the step response data, giving the following parameters: T1 = 0.07, Tw = 0.073, and ζ = 0.48. The comparison between the step response of the true system and the model can be seen in Figure 8 below, again indicating a near-ideal fit.

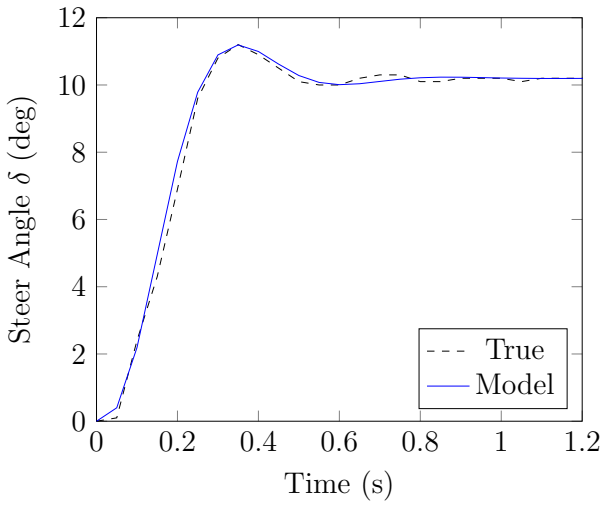
[picture p25: figure]
Time (s); Steer Angle; δ (deg); True Model

Figure 8: Full-Scale Bicycle Servo Step Response

### 2.6 Model Verification

Since the bicycle is an unstable system, accurate model verification without a stabilising controller is near impossible. Even with a stabilising controller in place, it is challenging to attain any kind of step or frequency response data. Therefore, model verification will be undertaken implicitly by analysing if the theoretically obtained control laws do indeed give stability when implemented on the real-world system.

3 CONTROLLER DESIGN AND SIMULATION | 16

## 3 Controller Design and Simulation

This section details the controller design process for the bicycle, where three controller types were investigated: PID, LQR, and H∞ loop-shaping. Since the steering angle is the only control variable and the lean angle is the only measured variable, the controller design problem is a single-input, single-output (SISO) type.

For simulation, the second order non-linear model derived in the previous section will be used to test the suitability of the final controller designs. This is to determine if the controller will still manage to stabilise the bicycle, even if it is perturbed outside of the linear range the controller is designed for. Thus, all following plots are using the non-linear model.

The simulation and development environment was chosen to be Matlab and Simulink. Additionally, a bicycle simulator was developed from first principles using the game engine Unity and C#. This gives a full 3D representation of the bicycle dynamics and allows real-time simulation, where the user can impose disturbances, and change various parameters on the fly, such as controller gains, sensor noise, actuator limits, and so forth. The non-linear differential equation of the second order model was integrated using the fourth order Runge-Kutta method. A screenshot of the custom simulator is given in Figure 9 below.


Figure 9: Custom Bicycle Simulator

3 CONTROLLER DESIGN AND SIMULATION | 17

For the sake of brevity, this section will only give detailed explanations of the controller design process for one of the two bicycles, namely the Lego prototype. The controller designs for the full-scale bicycle follow essentially the same logic, given that the plant and actuator models are of the same form, and thus the design steps need only be described once. However, the final controller designs and their performance in simulation will be given for both bicycles.

### 3.1 Performance Requirements

When designing a control system, it is important to be aware of any requirements and specifications that need to be met as to tailor the control law to those needs. In the case of the rider-less bicycle, the main goal is to ensure stability across a relatively broad range of forward speeds.

In addition, should stability be achieved, it is desirable to have a controller that is primarily focused on reducing the effects of disturbances acting on the bicycle, as opposed to tracking the reference since this will be predominantly set to zero. Disturbances could be as small as an uneven road or path that the bicycle is riding over, and as large as a strong gust of wind giving the bicycle a sideways push. As a further consideration, the amount of overshoot should be limited, so as not to excite any non-linearities by deviating too far from the linear operating point the controller is designed for.

For all controllers, the output is limited to ±60 degrees to prevent extreme steering angles.

Furthermore, the cross-over frequency needs to be kept above the frequency of the right-half plane pole, as there the phase lead provided by the pole is needed to ensure an encirclement of the -1 point on the Nyquist diagram.

Overall however, the bicycle, as an under-actuated system with only a handlebar actuator, is an incredibly difficult system to control. This therefore limits the control performance one can expect and reduces the number of performance constraints that can be placed on it.

### 3.2 Operating Point

As the bicycle models are strongly dependent on forward speed, it needs be to ensured that that the controllers can cope well with changes in velocity. However, to simplify controller design and to reduce the amount of symbolic expressions, an operating point is selected (i.e. a specific forward speed) and controllers designed for that specific operating point. This

3 CONTROLLER DESIGN AND SIMULATION | 18

process can be repeated over a large range of forward speeds and then during the final implementation, the controllers can be gain-scheduled using gain look-up tables.

For the Lego prototype, the maximum achievable speed was found to be V = 0.44ms⁻¹ ,
which is thus chosen as the operating point. An increase in speed would be desirable to enable better control performance, however this was limited by the motors available.

For the full-scale bicycle, the operating point was empirically selected to be V = 3ms⁻¹ .
This was chosen to be deliberately low for safety reasons, as not to damage the bicycle or any surrounding objects, should the bicycle become uncontrollable. Additionally, a control system that works for low speeds is harder to achieve, and therefore any increase in speed will make the control design easier.

### 3.3 PID

A first controller design using a Proportional-Integral-Derivative (PID) controller was investigated, for which the block diagram, including actuator Ga(s) and plant dynamics G(s), can

be seen in Figure 10 below. PID controllers are used extensively in control engineering for their relative simplicity and overall good performance in a multitude of scenarios.

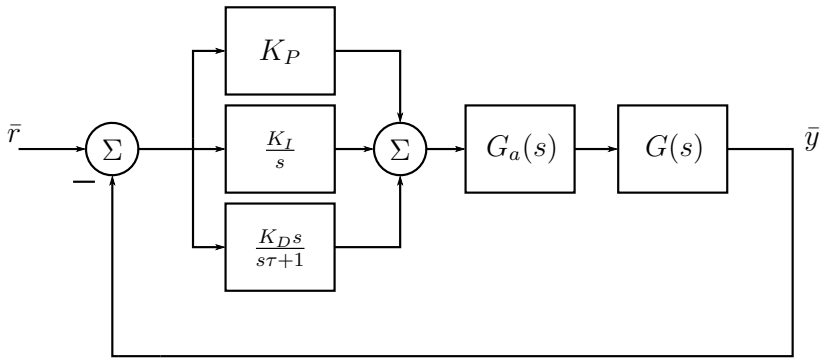
[picture p26: figure]
KDs sτ+1

Figure 10: PID Controller Block Diagram

From the block diagram it can be seen that a band-limited differentiator is used, since a pure differentiator is not realisable in practice as the gain increases indefinitely as the frequency increases. Additionally, a pure differentiator amplifies high-frequency sensor noise in the system, which in turn greatly decreases control performance and actuator lifespan. Thus, a practical band-limited differentiator flattens off the gain at a cross-over frequency (in rads⁻¹ )

given by τ

−1
. It can be seen as a pure differentiator followed by a first-order low-pass filter.

3 CONTROLLER DESIGN AND SIMULATION | 19

Lego Prototype
Firstly, closed-loop stability is to be achieved. From Equation 3, the bicycle can in theory be stabilised using a proportional-only controller with gain satisfying:

KP > 11.4

However, this is without considering the effects of the actuator. Cascading the plant with the actuator gives the following root locus diagram:

−20 −15 −10 | −5 | 5 | 10

−20

20

Im

Re

Figure 11: Root Locus for KP > 0

As can be seen from the plot, there is now an additional upper bound on the gain, as the pair of complex conjugate poles move towards and into the right-half plane as KP increases further. Thus, the closed-loop system is stable for a proportional gain in the range of:

11.4 < KP < 14.3

After choosing a proportional gain, both an integral gain and derivative gain can be chosen using the same root-locus approach by reforming the controller and plant into the respective Evans’ form:

1 + KI

Ga(s)G(s)
s(1 + (1 + KP )Ga(s)G(s)

= 0

1 + KD

sGa(s)G(s)
1 + (1 + (KP + KI/s)Ga(s)G(s)

= 0

Integral gain is chosen to give zero steady-state error when the system is subjected to a constant disturbance, whereas derivative gain is then chosen to increase the damping of the system, thus reducing the oscillations.

3 CONTROLLER DESIGN AND SIMULATION | 20

Lastly, the time constant τ , which determines the cut-off frequency of the band-limited differentiator, is chosen by iteration so that stability and sufficient damping of the closed-loop system is maintained. However, τ must be kept large enough to suppress sensor noise from corrupting the response.

In this way the parameters were chosen to be: KP = 12, KI = 38, KD = 0.44, and τ = 0.00062. The response to an impulse disturbance of magnitude 10 at the input and the corresponding actuator effort can be seen in Figure 12 below.

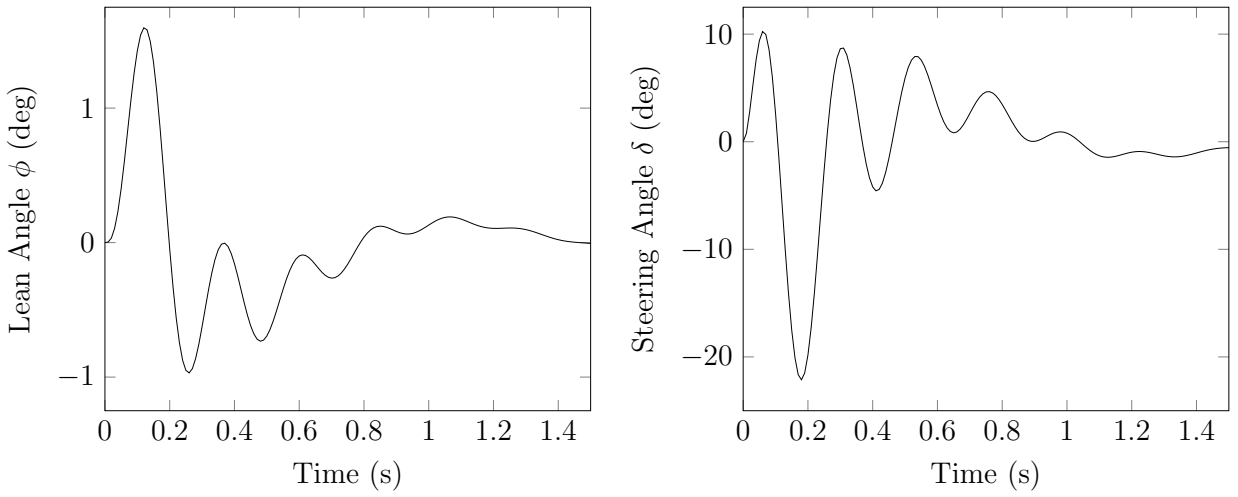
[picture p27: figure]
Time (s); Lean Angle; φ (deg); Steering Angle; δ (deg)

(a) Lean Angle Response
(b) Actuator Effort

Figure 12: Lego PID Controller Response

As can be seen from the plots, the PID controller in simulation can recover from an impulse in approximately one second whilst keeping the controller effort relatively small. The response is rather oscillatory however due to the addition of the integrator.

### 3.4 Linear Quadratic Regulator

As a second controller type, optimal linear control was investigated by means of an infinitehorizon linear quadratic regulator (LQR), which aims to minimise the cost function for the

state-space realisation ˙x = Ax + Bu, y = Cx,

J =

Z ∞

0

(x

TQx + u

T Ru)dt.

Where Q and R are positive semi-definite matrices, which respectively penalise having non-zero states and non-zero control inputs. The minimum cost is achieved by solving the Control

3 CONTROLLER DESIGN AND SIMULATION | 21

Algebraic Riccatti Equation (CARE):

0 = C

T C + XA + ATX − XBBTX

To give the stabilising feedback law,

u = −B

TXx.

The second-order bicycle model can be transformed into state-space form using controllable canonical form and results in the following system matrices:

A =

"
0 | 1
mgh J | 0
, B =

"
0
1

C =

h
mhV ²
bJ

V D

bJ i

As before, the control input u is the steer angle δ and the output y is the lean angle φ. For simplicity, the actuator model was not taken into account, as to keep the state dimension low.

Unfortunately, the states are not directly measurable. However, since the rank of the observability matrix O(A, C) is equal to the state dimension and the system is thus observable, an

observer can be used to estimate the internal states of the system, given measured inputs and outputs. For simplicity, it was decided to use the Luenberger observer given by,

xˆ˙ = Axˆ + Bu + L(y − yˆ).

Where ˆx denotes the state estimate. The rate of change of the estimation error ˙e = (A − LC)e is determined by the eigenvalues of the matrix A − LC. Thus, L must be ap-

propriately chosen to ensure that the estimation error approaches zero quickly.

As pictured in Figure 13 below, the state estimates of the observer can then be used in conjunction with the state-feedback matrix K given by the LQR to form the closed-loop system.

3 CONTROLLER DESIGN AND SIMULATION | 22

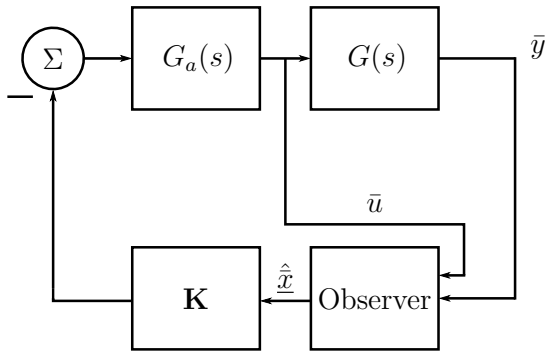
[picture p28: figure]
K Observer

Figure 13: LQR Controller Block Diagram

The choice of Q and R, which for a single-input system is a scalar, in general is not trivial. However, some constraints can be placed on the magnitudes of both. For the bicycle, it is desirable to reduce actuator effort, which is achieved by increasing the magnitude of R. Rapid stabilisation in turn is brought into effect by increasing the elements of Q, thus heavily penalising a non-zero state.

Lego Protoype
Values for Q and R for the Lego prototype model were chosen by iteration. The solution to the CARE and thus the resulting state-feedback gains were computed using the Matlab command lqr and resulted in the following gain matrix:

K =

h

180 19i

In addition, the observer gain matrix L was selected via pole placement and was iteratively found to give the best estimation results when the poles are located at −2, −4:

L =

h
0.69 1.0

iT

It was observed that changing the values of both Q and R over a broad range resulted in minimal changes in the controller gains. Thus, Q and R were simply set to the identity matrix and 1 respectively. The resulting response to an input disturbance is shown in Figure 14 below.

3 CONTROLLER DESIGN AND SIMULATION | 23

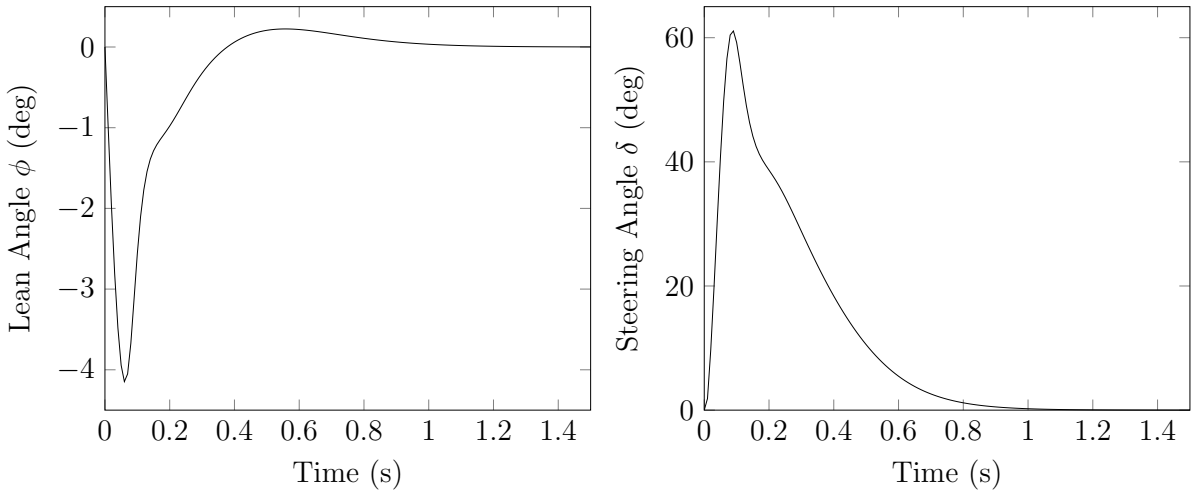
[picture p29: figure]
Time (s); Lean Angle; φ (deg); Steering Angle; δ (deg)

(a) Lean Angle Response
(b) Actuator Effort

Figure 14: Lego LQR Controller Response

### 3.5 H∞ Loop-Shaping

The second order model of the bicycle is an extremely simplified formulation of the actual system dynamics and parameters of the bicycle are only approximately known. Furthermore, the plant changes significantly with forward speed. Thus, it is important to maximise the robustness of the closed-loop system to plant perturbations, so that stability is achieved for a broad range of uncertainties. H∞ loop-shaping is concerned with robust stabilisation and thus an ideal candidate for this problem. The aim is to find a stabilising controller that maximises robustness, whilst trying to achieve a desired loop-shape of the return ratio. This section briefly covers aspects of the theory and then describes the prototype controller design process using this method.

For a general transfer function matrix G(s), which is analytic in the right-half plane and

satisfies supRe(s)>0

|G(s)| < ∞, the H∞ norm of the system is defined as,

kG(s)k∞ = sup

ω

σ¯(G(jω)).

Where ¯σ denotes the maximum singular value. For a single-input, single-output system the problem reduces to finding the supremum of the magnitude for all ω.
Since the bicycle transfer function used for controller design has poles in the right-half plane, it is not in H∞. Therefore, a normalised co-prime factorisation of the plant must be found,

3 CONTROLLER DESIGN AND SIMULATION | 24

so that

G0(s) = M˜ ⁻¹N˜

M˜ M˜ ∗ + N˜N˜ ∗ = I.

With M˜ and N˜ both in H∞ and no common zeros in the extended right-half plane. Here, the

factorisation is left-coprime. By then considering uncertainties in the coprime factorisations (∆M and ∆N , both in H∞), the uncertain plant can be modelled as:

G∆ = (M˜ + ∆M)
−1

(N˜ + ∆N )

with
k[∆M, ∆N ]k∞ ≤ .

Then, by the Small Gain Theorem, it can be shown that the closed-loop system is internally stable for all k[∆M, ∆N ]k∞ ≤ if and only if,

b(G, K) =

"
K
I
(I − GK)

−1

h

I Gi

∞

≥ .

b(G, K) is known as the stability margin. H∞ loop-shaping aims to find a stabilising controller K that maximises b(G0W, K), where the weighting function W(jω) shapes the return

ratio as desired.

In practice, this is achieved using the Matlab Robust Control Toolbox, where functions are available for computing normalised coprime factorisations (ncfmr), as well as the optimal, stabilising controller using the Glover-McFarlane method (ncfsyn) proposed in [6].

Furthermore, it may be more convenient to use the ν-gap metric (denoted by δν(G0, G1))

to check for robustness. In general, a gap between two plants G0 and G1 gives the smallest value of k[∆M, ∆N ]k∞ that perturbs G0 into G1. Thus, if the closed-loop system is stable for

G0 and K, then K will also stabilise G1 if and only if,

δν(G0, G1) < b(G0, K).

Thus, after having computed a stabilising H∞ optimal controller, the ν-gap metric can be used to determine the range of forward speeds, as well as the maximum uncertainties in system parameters, that can be tolerated in order to maintain closed-loop stability.

3 CONTROLLER DESIGN AND SIMULATION | 25

Table 3 below gives numerical values for the ν-gap between the nominal Lego prototype plant, again including the actuator model, and expected plant perturbations.

Parameter | Variation | ν-gap
Forward speed v | ±30% | 0.046,0.0615
Mass m | ±5% | negligible
Center of mass h | ±20% | 0.057,0.047
Center of mass a | ±20% | 0.019,10.018
Wheel Base b | ±10 | 0.012,0.0098
Moment of Inertia D | ±25% | 0.022,0.022
Moment of Inertia J | ±25% | 0.073,0.057

Table 3: ν-gap Estimates for Expected Variations in Plant Parameters

As is evident from the table above, single variations in parameters are bounded by a maximum ν-gap of approximately 0.073. However, taking into account that there inevitably will be uncertainties in all parameters, the corresponding ν-gap between the nominal and true plant will be significantly higher. Thus, as a general rule of thumb, a stability margin b(G0, K) of at least 0.2 will be sought out to ensure robustness.

Lego Prototype
The frequency response of the nominal Lego Prototype model, including the actuator model, is shown in Figure 15 below.

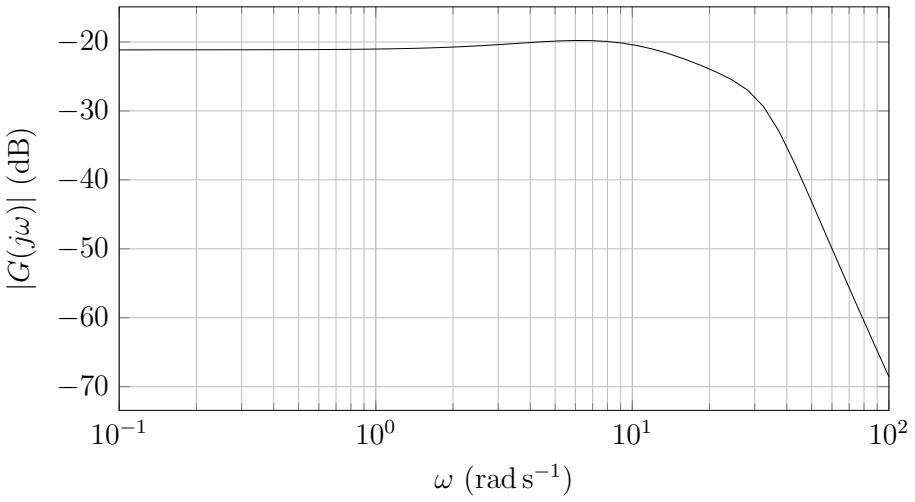
[picture p30: figure]
ω (rad s⁻¹

Figure 15: Bode Magnitude Plot for Lego Prototype Model

3 CONTROLLER DESIGN AND SIMULATION | 26

As previously mentioned, it is clear that a proportional gain of KP > 11.4 is needed for stability at this nominal forward speed. Thus, as a first step, a proportional gain of KP = 12 is included in the weighting function W(jω). The plant can now be further shaped so that

the closed-loop system has desirable properties, such as the typical requirements of reduced sensitivity at low frequencies (for good tracking and disturbance rejection) and reduced complementary sensitivity at high frequencies (to reduce the effects of sensor noise). Additionally,

it is important to note that actuator limits must be taken into account, as not to make the demands on the system too large. This can be avoided by ensuring that the loop gains are not made arbitrarily large and that the target bandwidth of the system is bounded reasonably.

An appropriate weighting function, to give b(G0, K) ≥ 0.2, was then found by iteration and

is comprised of three elements:

1. Proportional Gain: Keeps the cross-over frequency above the frequency of the right-half plane pole as to aid stability.
2. Integrator : Improves disturbance rejection and reference tracking by providing gain at low-frequencies.
3. Zero: Increases the bandwidth of the system and ensures the slope of the magnitude flattens off around the cross-over frequency. This helps improve the phase-margin, by keeping the phase away from −180◦ at 0dB.

The overall weighting function is therefore,

W(s) = 12 ·

s + 1
s

Then using Matlab to synthesize the controller resulted in a stability margin of b(G0, K) =

0.24 with a sixth-order controller of the following form:

K(s) = W(s)K∞(s) =
12 ·

s + 1
s

4 ·

(s + 0.17)(s + 8.9)(s + 18)(s

2 + 25s + 1110)
(s + 1.1)(s + 4.3)(s + 48)(s

2 + 32s + 2370)

The frequency response of the shaped loop, in comparison to the desired and nominal loop, is shown in Figure 16 below.

3 CONTROLLER DESIGN AND SIMULATION | 27

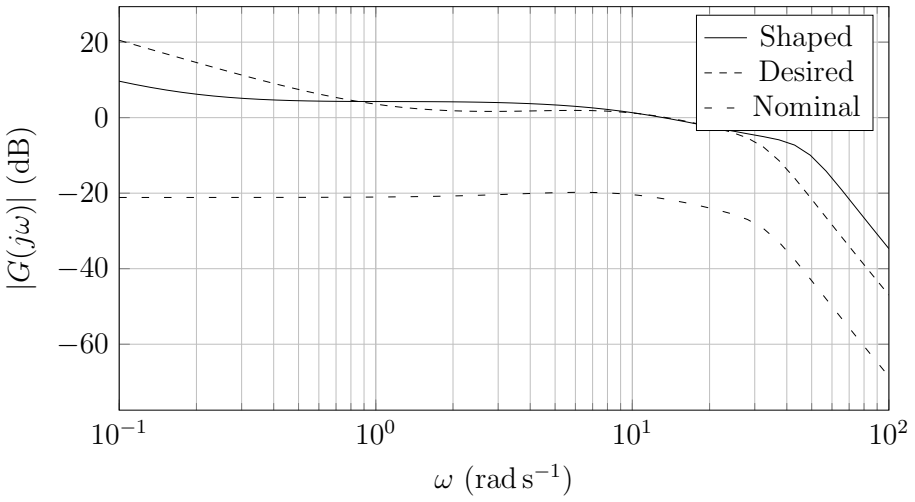
[picture p31: figure]
ω (rad s⁻¹; Shaped Desired Nominal

Figure 16: Bode Magnitude Plot for Shaped Lego Prototype

As can be seen from the plot, the final loop shape is not exactly the desired loop shape. In particular, the gain at low frequencies is reduced to maintain stability, however the cross-over frequency is approximately the same. The response to an input disturbance using the H∞ loop-shaping controller can be seen in Figure 17 below.

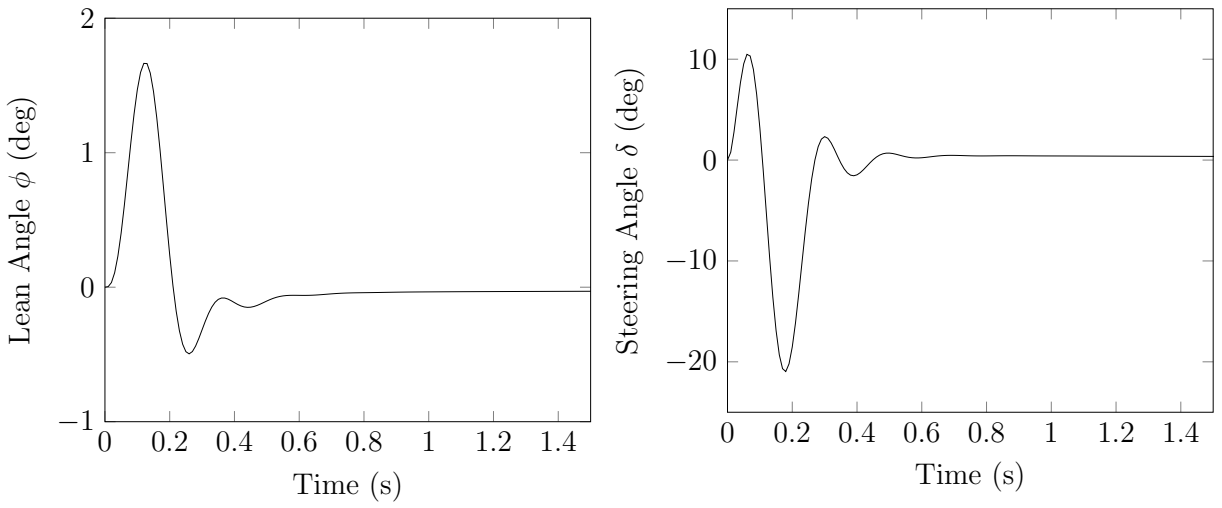
[picture p32: figure]
Time (s); Lean Angle; φ (deg); Steering Angle; δ (deg)

(a) Lean Angle Response
(b) Actuator Effort

Figure 17: Lego H∞ Controller Response

### 3.6 Non-Linear Methods

As opposed to having several linear controllers gain-scheduled for different operating points, want a single controller that works sufficiently well at any forward speed.

3 CONTROLLER DESIGN AND SIMULATION | 28

### 3.7 Comparison and Robustness

In simulation, out of all investigated controller designs, H∞ loop-shaping provided the most desirable response. In particular, the recovery time due to a disturbance is small, the actuator effort reasonably bounded, due to the integrator there is zero steady-state error, and importantly the lean angle is kept small as to keep the system in the linear operating regime. Furthermore, the H∞ controller synthesis also directly provides an estimate of the robustness of the closed-loop system, as stated previously.

On the other hand, PID control is the simplest to implement and tune on-the-go, whilst still providing satisfactory performance and the smallest controller effort. As a measurement of robustness, the phase margin of the nominal, PID-controlled system was found to be adequate at just under 30◦

Lastly, the simulated LQR controller performance was the worst out of all three. In particular, the lean angle deviated the most with an excessive steering angle imposed on the actuator to maintain stability. A measure of robustness for this controller type is also not directly available.

### 3.8 Implementation Details

All controller designs were performed in the continuous domain. However, as the controllers will eventually be implemented on a digital microprocessor, they need to be discretised. This is achieved by using the Tustin transformation, which maps the s to the z domain as follows:

s →

2
T

z − 1
z + 1

The Tustin transform achieves the best frequency domain match between continuous and discrete systems. The choice of sampling time T is critical for two reasons:

1. A small value of T will reduce the effects of frequency warping induced by using the Tustin transform.
2. T must be chosen small enough so that the controller can react to the plant dynamics up to all relevant frequencies. As a general rule of thumb, the sampling time should be chosen so that T ≤

2π
10ωc

, where ωc is the bandwidth of the plant.

However, the smallest possible sampling time is limited by the computational power of the processor.

4 IMPLEMENTATION: LEGO PROTOTYPE | 29

Another implementation detail is the prevention of integrator wind-up. For instance, a large error signal sustained over a longer period of time can cause an integrating controller to produce a very large output, which will cause large amounts of overshoot, as well as instability. To counter-act this problem, all integrators will be limited using a dynamic clamping scheme proposed in [7].

As a last consideration, the controller output is limited to ±60◦ as to not cause excessive

steering angles to be demanded of the actuator.

## 4 Implementation: Lego Prototype

After having completed the modelling and controller design for both bicycles, the final designs could then be tested on the real-world system. Firstly, the implementation using the Lego prototype bicycle was investigated, since it is quickly assembled, and easier to test in a confined space, compared to the full-scale bicycle.

### 4.1 Hardware

The Lego prototype was made up of standard Lego Mindstorms EV3 parts. In particular, two large motors are used in parallel to propel the bicycle forwards at a maximum possible speed, whilst a smaller motor was placed at the handlebars to actuate the front fork assembly. Only a single gyroscopic sensor was available to provide a measurement of the rate of change of the lean angle. Lastly, the Lego EV3 Brick served as the central processing system, with a 300 MHz ARM processor, 16MB of Flash memory, and 64MB of RAM.

### 4.2 Software

The microprocessor was programmed using RobotC, a C-derivative specifically for Lego systems. The software structure is outlined in pseudo-code below.

Listing 1: Lego Software Pseudo-Code

initialiseSensorsAndMotors();

bias = calibrateGyroscope();

startDriveMotors(maxSpeed);

startTimer();

while (true) {

4 IMPLEMENTATION: LEGO PROTOTYPE | 30

if (currentSampleTime >= desiredSampleTime) {

leandot = getSensorMeasurement() - bias;

lean = estimateLeanAngle(leandot);

ctrl = computeControllerOutput(0.0 - lean);

pos = actuateHandlebarMotor(ctrl);

logData(time,lean,ctrl,pos);

}

}

The calibration routine records a fixed number of measurements and calculates their mean. This mean bias is then subtracted from each subsequent measurement in the control loop. The controller function computes the output of a difference equation obtained via discretisation, as mentioned in the previous section. Logging of data was achieved via Bluetooth using RobotC’s inbuilt logging functionality. Finally, the desired sample time was chosen to be T = 0.01s.

### 4.2.1 Lean Angle Estimation

The Lego bicycle is only equipped with a gyroscopic sensor, meaning that only the rate of change of the lean angle is directly measurable. Direct integration of this measurement to give an estimate of the lean angle is not possible, since the measurements are corrupted by noise and the gyro has a time-varying bias. This noise and gyro bias will cause a drift in the estimated lean angle over time and thus deviate quickly from the true lean angle.

Therefore, it is necessary to estimate the lean angle at every timestep using a continuous-discrete Extended Kalman Filter (EKF). The EKF fuses the approximately-known, linearised,

continuous system dynamics with discrete, noisy sensor readings to give an overall improved state estimate. Th full derivation of the EKF is given in [8]. The state vector and model

dynamics are taken from the second-order model given in section 2.3. Note that this entire state estimation step would not be necessary if an accelerometer were available, which could be used as reference to correct for drift.

The continuous-discrete EKF can be divided into two steps. Firstly, the prediction step uses the system dynamics to estimate the state vector a timestep T in the future:

xˆ = ˆx + T · A

P = P + T · (AP + PAT + Q)

Where ˆx is the state estimate vector, A is the linearised state-transition matrix, P is the

4 IMPLEMENTATION: LEGO PROTOTYPE | 31

error covariance matrix, and Q is the model noise matrix.

Following this, the update step fuses the linearised dynamics with the noisy sensor readings:

K = PCT

(R + CPCT
)

−1

P = (I − KC)P

xˆ = ˆx + K(ym

− Cxˆ)

Where ym

is the measurement vector, C is the state output matrix, R is the measurement noise matrix, and K is the Kalman gain, which places a weighting on the measurements and internal model predictions.
Q is chosen depending on the model accuracy, whereas R is set to the noise covariance found in the sensor datasheet.

Lastly, it is important to note that an approximate model of the dynamics is used in conjunction with a noisy, biased sensor. Even though the resulting state estimation performance is much improved over using only the gyroscope readings, the inevitable inaccuracies will accumulate and degrade the lean angle estimate as time progresses. This ultimately has a direct impact on control performance and also only allows the final system to be tested for short periods of time before requiring a reset.

This is displayed in the simulated EKF state estimation in Figure 18 below, where it is evident that after an initially good estimation performance, after a brief amount of time the lean angle estimate starts to drift away from the true value.

4 IMPLEMENTATION: LEGO PROTOTYPE | 32

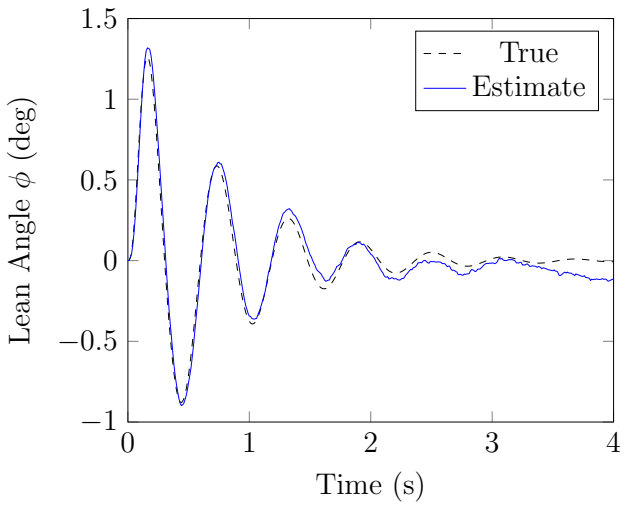
[picture p33: figure]
Time (s); Lean Angle; φ (deg); True Estimate

Figure 18: EKF Lean Angle Estimation

### 4.3 Results

### 4.3.1 PID

Proportional Only
A proportional-only controller was indeed able to stabilise the bicycle. As predicted by the second-order model and simulation, the bicycle could be stabilised at the given forward speed of V = 0.44ms⁻¹ by a gain greater than 11.4.

Figures 19 a) and b) show an excerpt of the response and actuator effort of the Lego prototype

for a proportional gain of KP = 12.

4 IMPLEMENTATION: LEGO PROTOTYPE | 33

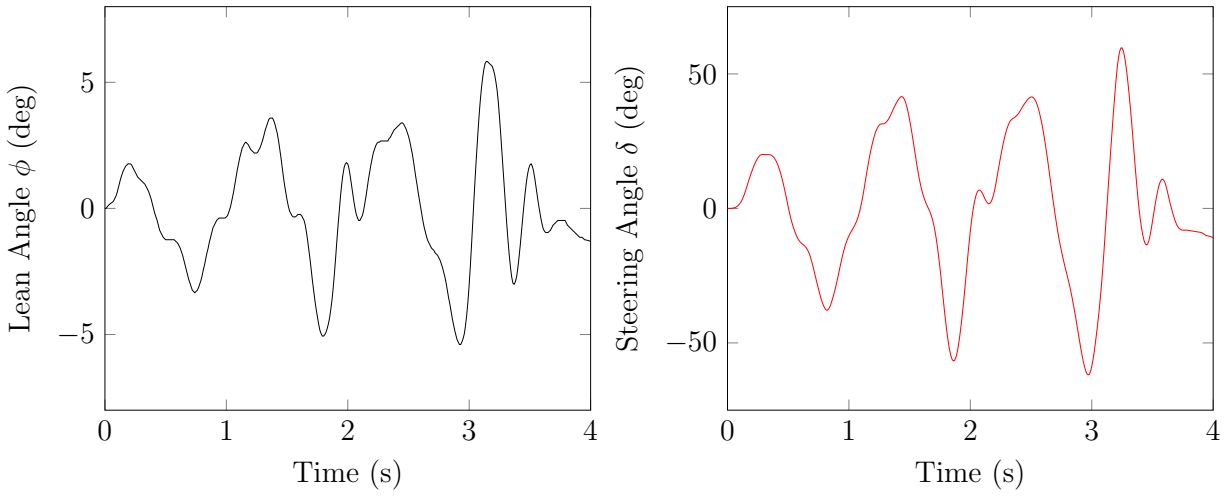
[picture p34: figure]
Time (s); Lean Angle; φ (deg); Steering Angle; δ (deg)

(a) Lean Angle Response

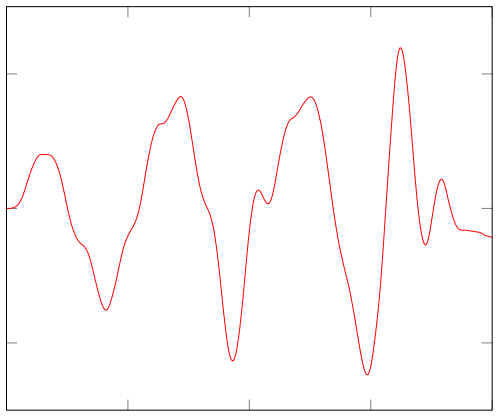
[picture p35: figure]

(b) Actuator Effort

Figure 19: P-Controller Response (KP = 12)

The response for the simple proportional controller is certainly not ideal, even though stability is achieved. The magnitude of the lean angle is bounded by approximately 5◦
, which
is an acceptable deviation from the desired setpoint of 0◦
. However, there is an oscillation present in the response, indicating that the system is on the boundary of stability. Knocking the bicycle gently, as to add an output disturbance, destabilises it. Thus the closed-loop system is not robust and sensitive to disturbances in its current state. This is to be expected however, since a proportional gain is used which places the closed-loop poles very close to the imaginary axis.
Furthermore, the jittering behaviour also causes the bicycle to move off-track easily and not follow a straight path. Lastly, the controller effort is larger than ideal.

Full PID Controller
Hello
Servo Model Verification
As a brief aside, the servo model is again verified by running a simulation in Matlab but using the real-world controller output data. As can be seen in Figure 20, the match is near perfect and confirms the actuator model identified in an earlier section of this report.

5 IMPLEMENTATION: FULL-SCALE BICYCLE | 34

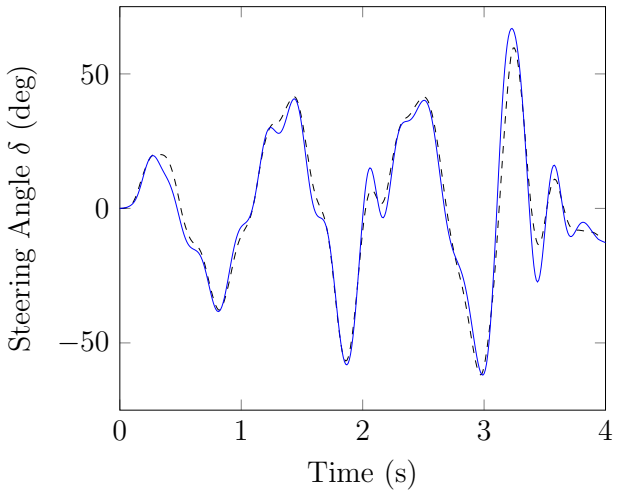
[picture p36: figure]
Time (s); Steering Angle; δ (deg)

Figure 20: Lego Servo Model Verification

### 4.3.2 LQR

Unfortunately, the LQR controller was not able to stabilise the Lego prototype, even with varying feedback gains. It is assumed that the reason for this instability is that not only is the system relying on an approximate estimate of the lean angle, but it is now also relying on an additional state observer, which is using this degraded state estimate to again infer a further set of internal states. Thus, these combined errors will be fed back to the control law, which as seen from the previous controller type is already at its limits using a single state estimator.

### 4.3.3 H∞ Loop-Shaping

### 4.3.4 Final Observations

hard to stabilise since h is small and time constants are short, not robust to disturbances. Have hardly any time to react. Additional limitation is maximum speed of lego model, which causes it to be very unstable. Stabilisation can be achieved but not a very good performance. Performance could probably be improved if we were to use a better angle estimation system, i.e. use an IMU. As soon as gyro estimate starts drifting we’re in trouble (which turns out to be pretty quickly)...

## 5 Implementation: Full-Scale Bicycle

Having successfully stabilised prototype bicycle...

5 IMPLEMENTATION: FULL-SCALE BICYCLE | 35
(a) Unmodified Form | (b) After Modification

Figure 21: Full-Scale Bicycle Before and After Modification

### 5.1 Hardware

Arduino (32-bit instead of 8-bit) as controller, why particular servo, servo mounting design,

battery, voltage regulators, drive motor, motor controller disassembly, etc.

### 5.1.1 Bicycle Frame

### 5.1.2 Drive Motor

### 5.1.3 Handlebar Actuator

### 5.1.4 Microprocessor and Sensors

### 5.1.5 Miscellaneous

### 5.2 Software

### 5.2.1 Code Layout

Loops at different sample times: IMU, controller, telemetry, etc.

### 5.2.2 Lean Angle Estimation

Again, it was necessary to estimate the lean angle from raw sensor data. In the case of the full-scale bicycle however, an inertial measurement unit (IMU) was available, comprised

of three gyroscopic sensors and three accelerometers, each aligned along an orthogonal axis. This meant that gyroscopic drift could now be directly accounted for without having to resort to the computationally expensive Kalman filter used for the Lego prototype.

5 IMPLEMENTATION: FULL-SCALE BICYCLE | 36

At rest, an accelerometer outputs a signal directly proportional to the gravitational vector, this can then be used as a reference to correct for gyroscopic drift. However, when in accelerated motion, the accelerometer output will be corrupted by other accelerations terms, such as linear or Coriolis.
The problems present in both accelerometers and gyroscopic sensors are alleviated by the use of a complementary filter. Simply put, an accelerometer is useful over a long duration of time, while a gyroscopic sensors useful over a short period of time. It is therefore possible to low-pass filtere Combining both favourable aspects of these sensors leads to the use of a complementary filter.
Complementary filter, gyro HPF and acc LPF, more stable since we have accelerometer to correct for drift

### 5.2.3 Basestation and Telemetry

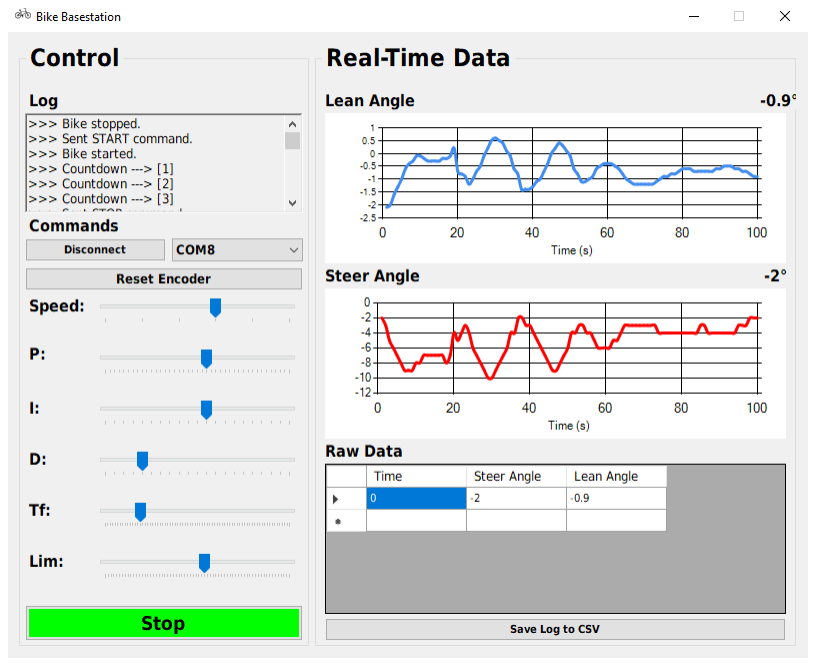
[picture p37: figure]

Figure 22: Screenshot of Bicycle Basestation

Packet handling, vary controller parameters on the fly, live data logging and display, safety start/stop, etc..

6 CONCLUSIONS AND FUTURE WORK | 37

### 5.3 Results

## 6 Conclusions and Future Work

For the actual real-world implementation, controller design is actually a small part of the work. Need to worry about acquiring good estimates of states, writing all the peripheral software, drivers, sizing actuators, modelling the system, estimating parameters, etc, etc. A controller that works in theory actually takes quite a lot of effort to work in practice. Extremely difficult to stabilise this system, made even harder due to underactuation and difficulty in verifying model. Possibly could try adding flywheel to provide lean torque. Maybe better modelling.
Currently only using lean angle feedback, to keep on straight path would need some way of knowing heading - future work?

## References

[1] Francis J. W. Whipple. Stability of the Motion of a Bicycle. The Quarterly Journal of Pure and Applied Mathematics, Vol XXX, 1899.
[2] A. L. Schwab, J. P. Meijaard, J. M. Papadopoulos. A Multibody Dynamics Benchmark

On The Equations of Motion of an Uncontrolled Bicycle. 5th Nonlinear Dynamics Conferencec, 2005.

[3] Karl J. ˚Astr¨om, Richard E. Klein, Anders Lennartsson. Bicycle Dynamics and

Control: Adapted bicycles for education and research. IEEE Control Systems, 10.1109/MCS.2005.1499389, September 2005.

[4] International Standard ISO 8855. Road Vehicles - Vehicle Dynamics and Road-Holding Ability - Vocabulary. Second Edition, December 2011.
[5] J. M. Papadopoulos, R. S. Hand, A. Ruina. Bicycle and Motorcycle Balance and Steer

Dynamics. Draft, July 1990.

[6] Duncan McFarlane, Keith Glover. A Loop Shaping Design Procedure Using H∞ Synthesis. IEEE Transactions on Automatic Control, Vol. 37 No. 6, June 1992.
[7] D. Wilson. Teaching Your PI Controller to Behave. Online: https://e2e.ti.com/blogs /b/ motordrivecontrol/archive/2013/04/13/teaching-your-pi-controller-to-behave-part-vii, (https://e2e.ti.com/blogs_/b/motordrivecontrol/archive/2013/04/13/teaching-your-pi-controller-to-behave-part-vii) April 2013.

A RISK ASSESSMENT | 38
[8] R. W. Beard, T. W. McLain. Small Unmanned Aircraft: Theory and Practice. Princeton

University Press, 2012.

## Appendix

## A Risk Assessment
