Husseinbeygi/CUED-Self-Balancing-Bike/Reports/Final Report/FinalReport.tex

\input{Preamble}

\begin{document}

\input{TitleAndContents}

\section{Introduction}
\input{sections/Introduction}

\section{Modelling}
\input{sections/Modelling}

\section{Controller Design and Simulation}
\input{sections/ControllerDesignAndSimulation}

\section{Implementation: Lego Prototype}
\input{sections/ImplementationLego}

\section{Implementation: Full-Scale Bicycle}
\input{sections/ImplementationFS}

\section{Conclusions and Future Work}
\input{sections/ConclusionsAndFutureWork}

\input{sections/References}

\section*{Appendix}
\input{sections/Appendix}

\end{document}
