Husseinbeygi/CUED-Self-Balancing-Bike/Reports/Final Report/sections/Appendix.tex

\begin{appendices}
\section{Links to Resources}
The source code for the entire project, as well as all supporting files, can be found in the following repository. This repository also serves the function of the project logbook. \\

\url{https://github.com/pms67/CUED-Self-Balancing-Bike} \\

Videos of the bicycles can be found using the following link: \\

\url{http://philsal.co.uk/projects/self-balancing-bike}

\section{Risk Assessment}
The risk assessment completed during Michaelmas term 2018 covered all risks encountered during the development of the prototype bicycle. However, the original risk assessment did not fully take into account the risks encountered during the development of the full-scale bicycle. This is due to the fact that the idea of investigating a full-scale bicycle was only conceived during a later stage in the academic year after being awarded a \textit{James Dyson Foundation} bursary. However, before implementing the full-scale bicycle, a further risk assessment was completed that again matched all encountered risks in the final implementation.
\end{appendices}
