Husseinbeygi/CUED-Self-Balancing-Bike/Reports/BodeBandlimitedDiff-eps-converted-to.pdf

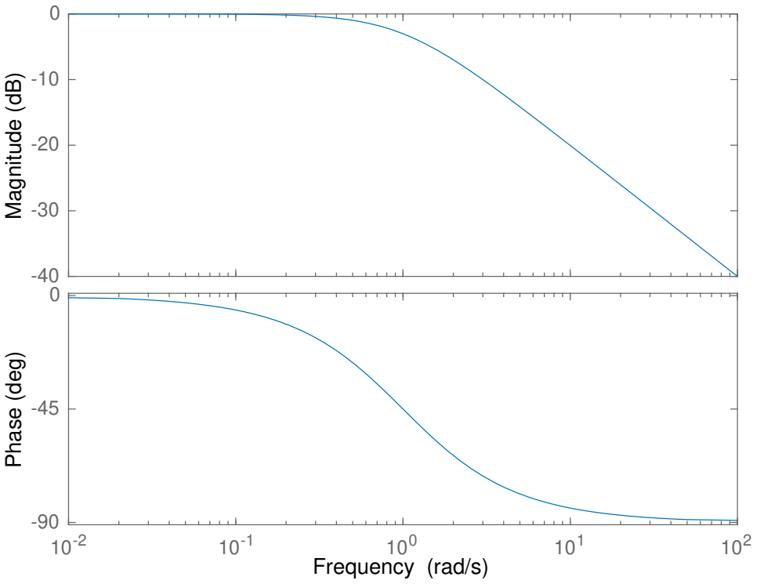
[picture p40: figure]
Magnitude (dB); Phase (deg); Frequency (rad/s)
