Husseinbeygi/CUED-Self-Balancing-Bike/Reports/Technical Milestone Report/TMR Feedback.pdf

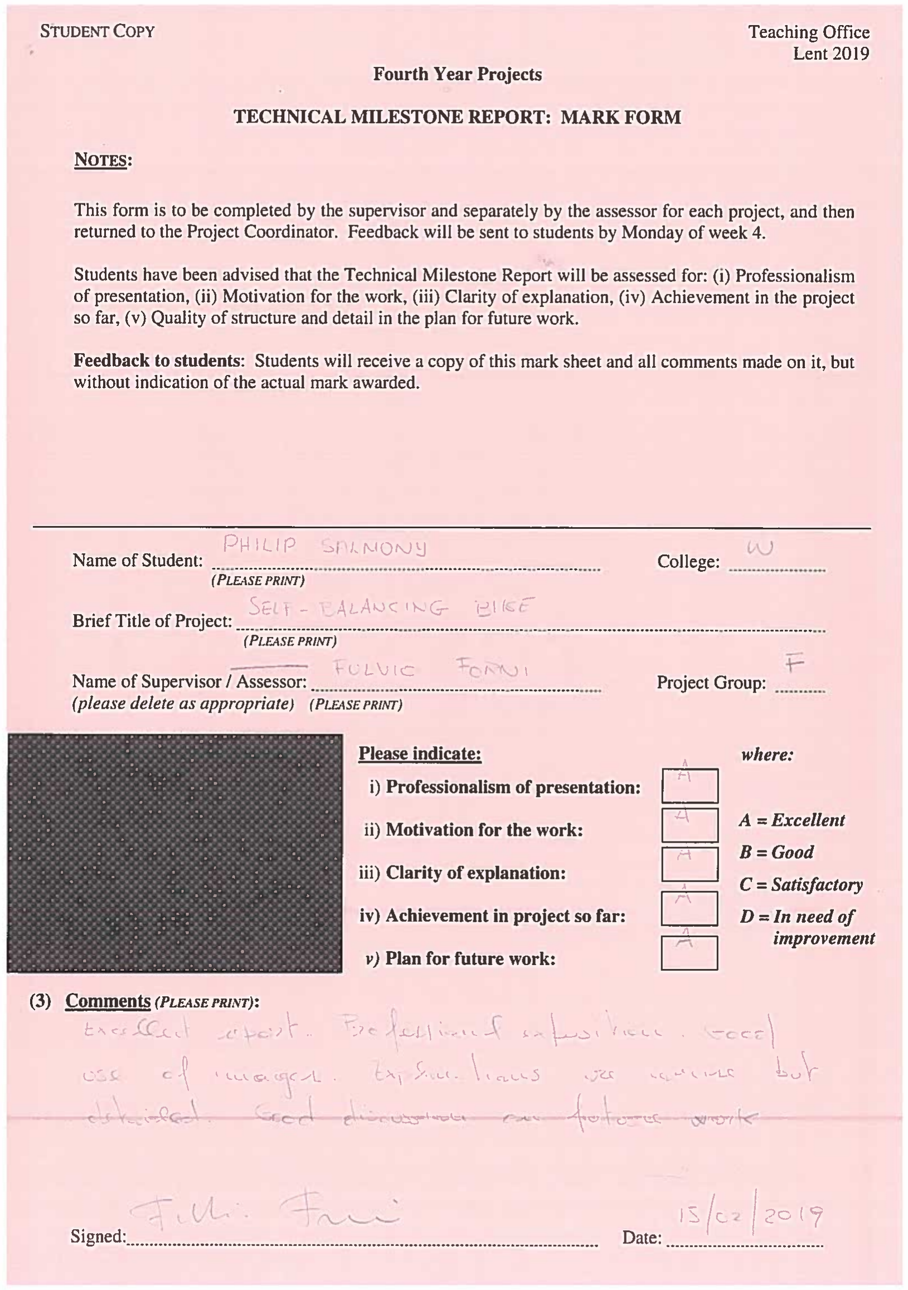
[picture p41: page 1]
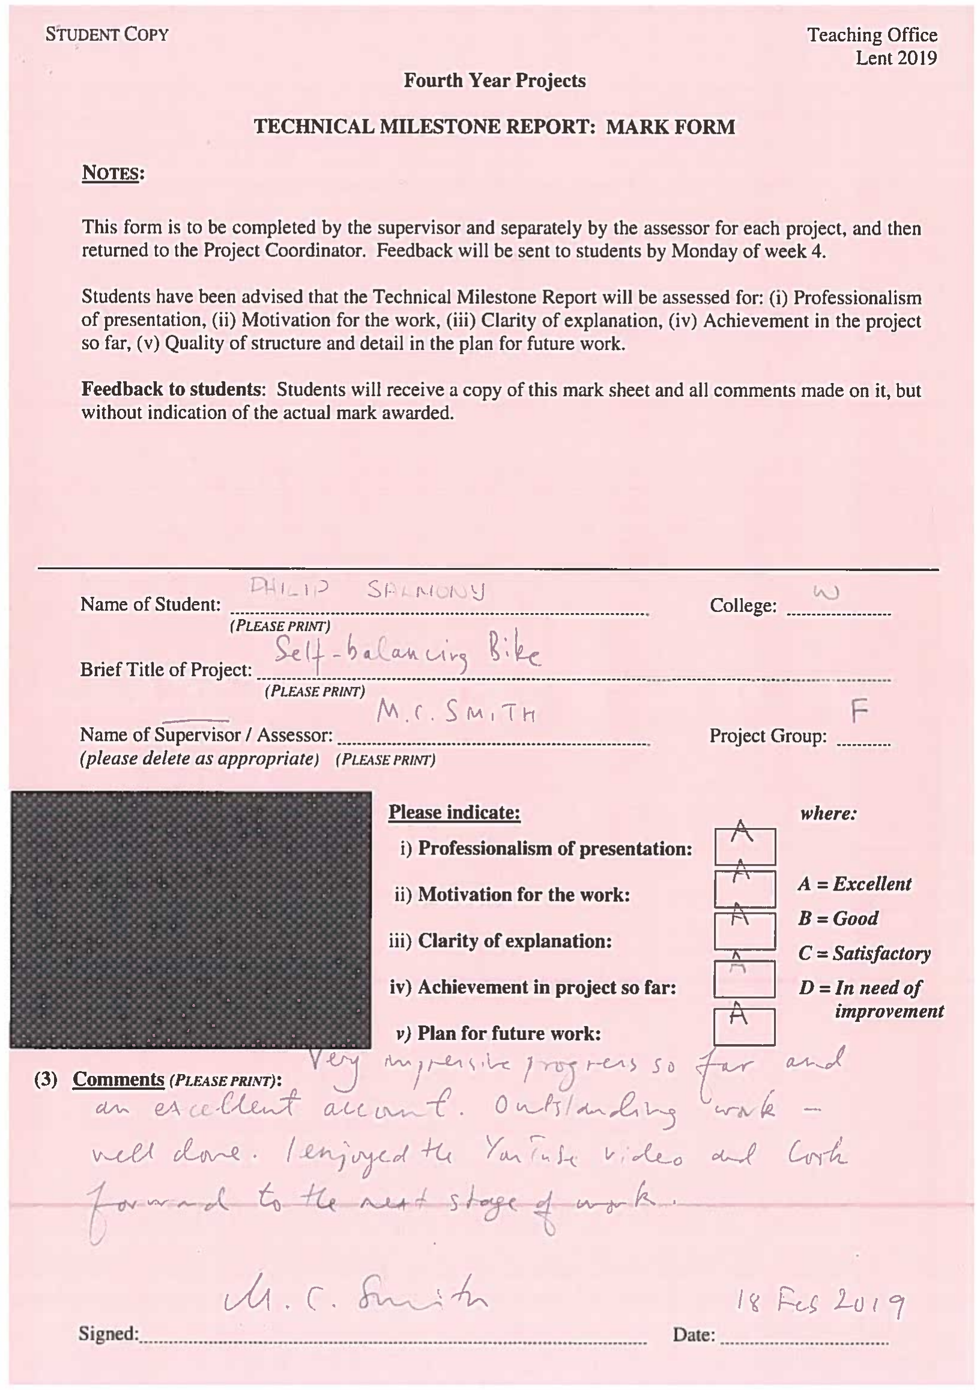
[picture p42: page 2]
