Husseinbeygi/CUED-Self-Balancing-Bike/Reports/Final Report/figures/compfilt.pdf

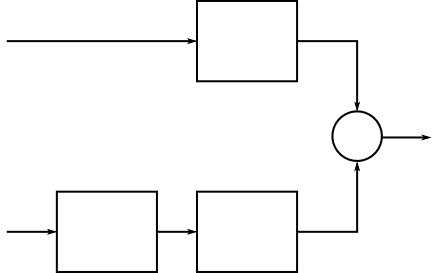
[picture p43: figure]
