Husseinbeygi/CUED-Self-Balancing-Bike/Reports/Final Report/figures/lqrblock.pdf

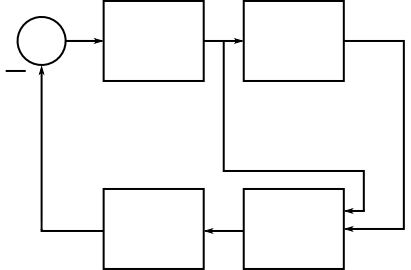
[picture p44: figure]
