Husseinbeygi/CUED-Self-Balancing-Bike/Reports/Final Report/figures/pidblock.pdf

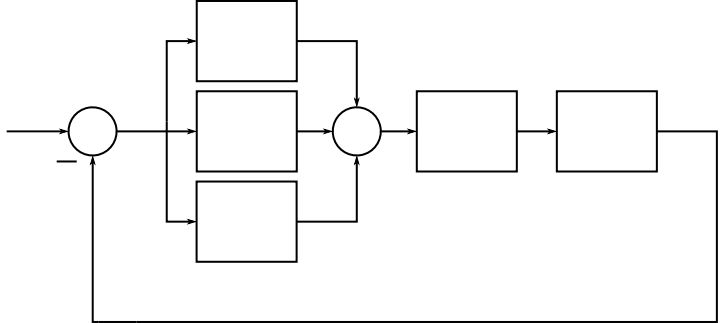
[picture p45: figure]
