Husseinbeygi/CUED-Self-Balancing-Bike/Reports/Final Report/figures/geometry1.pdf

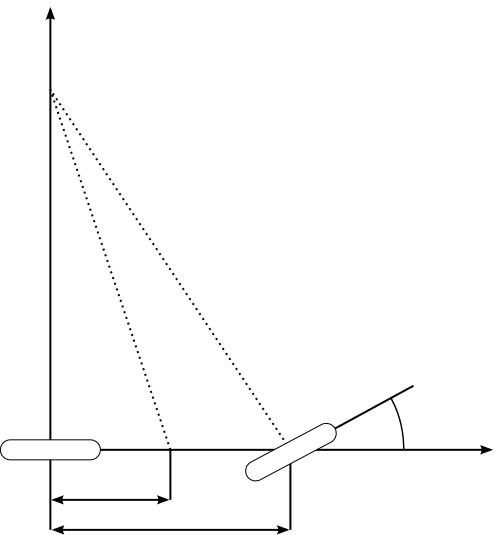
[picture p46: figure]
