Husseinbeygi/CUED-Self-Balancing-Bike/Reports/Final Report/figures/geometry3.pdf

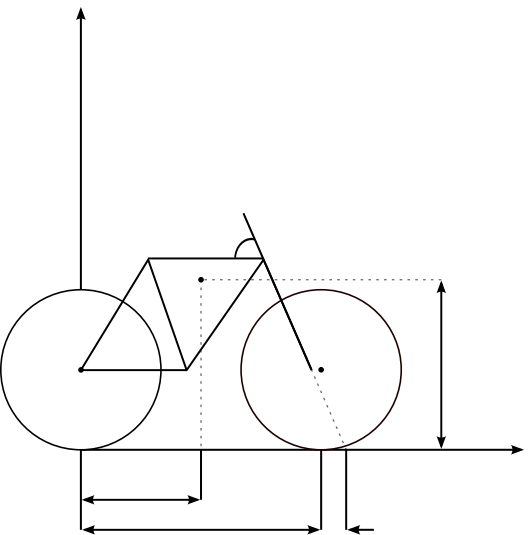
[picture p47: figure]
