Husseinbeygi/CUED-Self-Balancing-Bike/Reports/Final Report/figures/legoRLocus-eps-converted-to.pdf

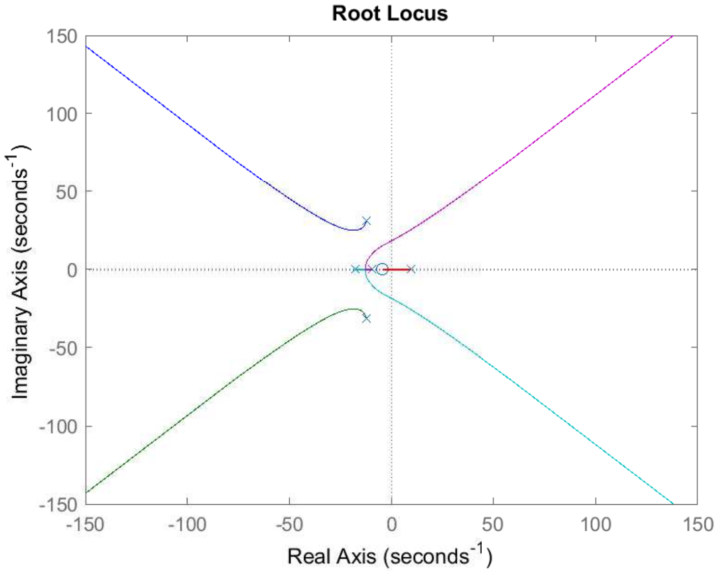
[picture p48: page 1]
