Husseinbeygi/CUED-Self-Balancing-Bike/administration/IIB Project Agreement.pdf

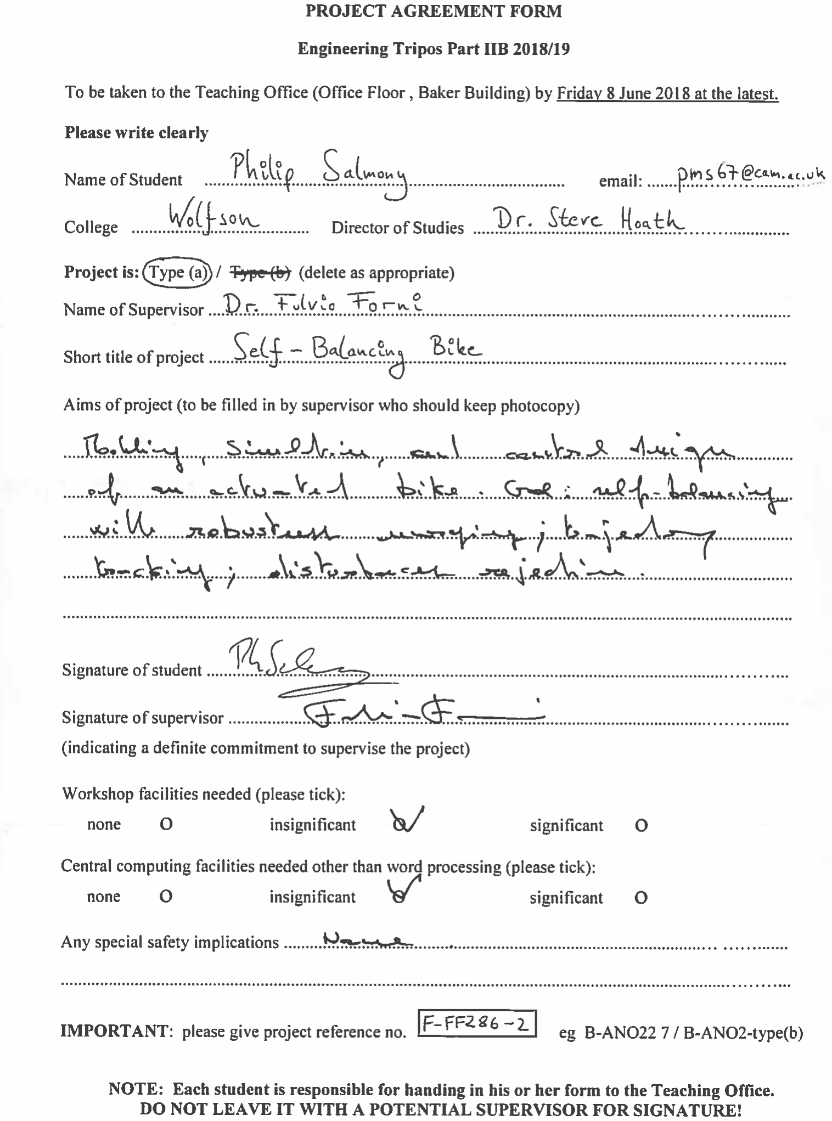
[picture p49: page 1]
