Husseinbeygi/CUED-Self-Balancing-Bike/Presentation/MichaelmasPresentation.pdf

## Self-Balancing Bike

Philip Salmony, Wolfson College

November 22, 2018

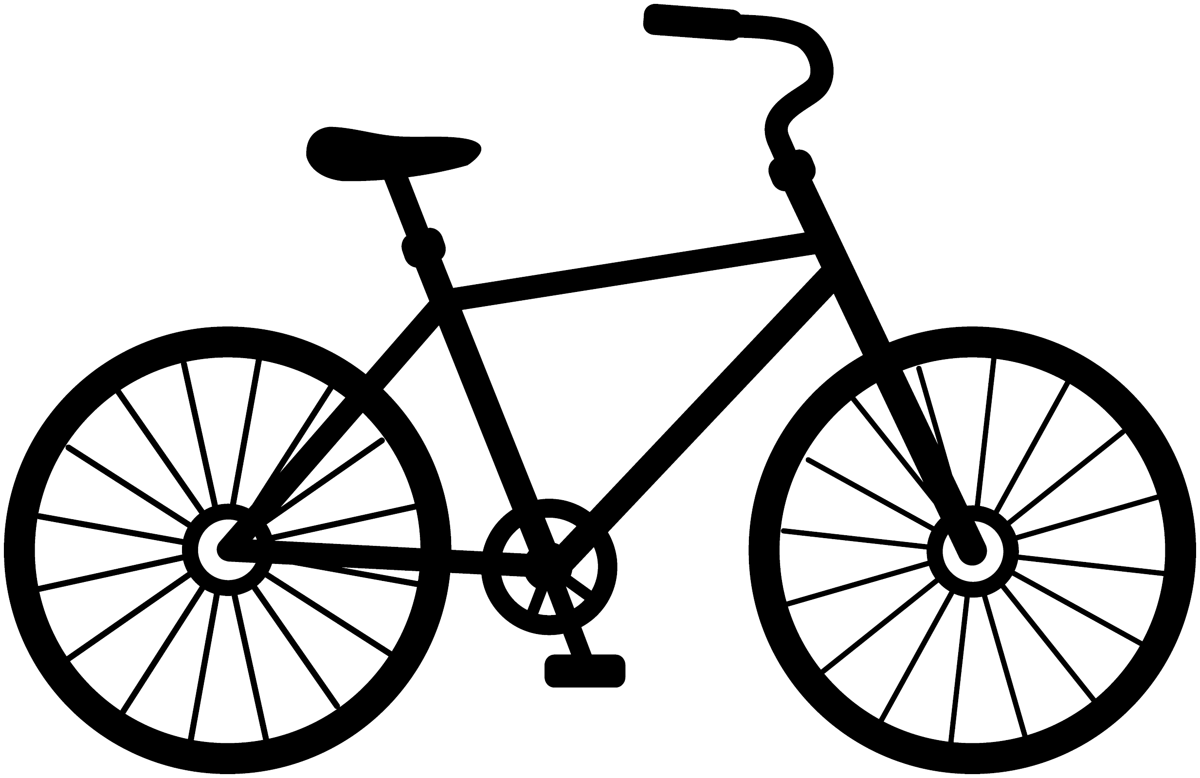
[picture p50: figure]

Philip Salmony, Wolfson College | Self-Balancing Bike | November 22, 2018 | 1 / 12

## Background and Context

Bicycle stability and equations of motion studied for well over 100 years.

e.g., Whipple (1899), Papadopoulos (1980s), Astrom (2005)

Still misconceptions about why a bike is self-stable.

”Inverted pendulum”

Under-actuated system

”Everybody knows how to ride a bike, but no one knows how we ride bikes.”

Philip Salmony, Wolfson College | Self-Balancing Bike | November 22, 2018 | 2 / 12

## Aims and Significance

How does a human stabilise a bicycle?

What makes a bicycle more or less stable?

Can we design a control algorithm that stabilises a bicycle in all situations?

Generally, an interesting but rather difficult control problem!

Philip Salmony, Wolfson College | Self-Balancing Bike | November 22, 2018 | 3 / 12

## Honda Self-Balancing Bike


Source: https://motorbikewriter.com/honda-self-balancing-bike-electric/
October 2017 - not very long ago!
Philip Salmony, Wolfson College | Self-Balancing Bike | November 22, 2018 | 4 / 12

## Progress - Modelling

Linear and non-linear bicycle models for simulation

Many, very complex and coupled non-linear, differential equations. Fourth-order linearised model, dependent on forward speed:

M · q¨ + C1 · v · q˙ + (K0 + K2v

2
) · q =
0
τ

Stability investigation

Developed simulations in Unity and MatLAB/Simulink

Philip Salmony, Wolfson College | Self-Balancing Bike | November 22, 2018 | 5 / 12

## Progress - Simulations (Unity)

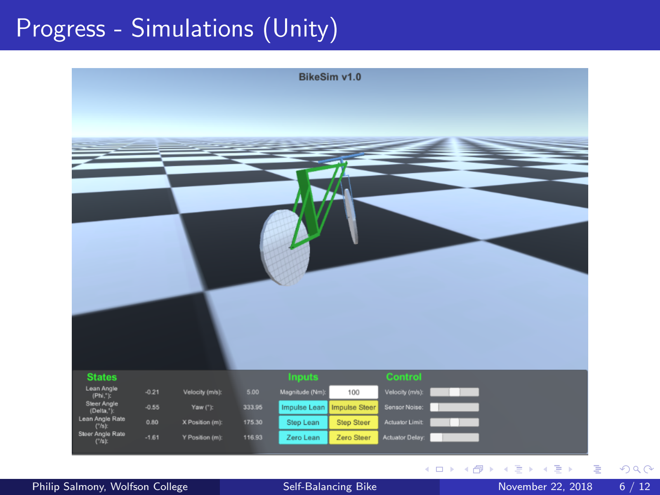
[picture p51: page 6]

Philip Salmony, Wolfson College | Self-Balancing Bike | November 22, 2018 | 6 / 12

## Progress - Controller Design

Investigated linear PD and LQR controller design

Limitation: need several controllers to cope with varying speeds!

Developed LEGO Mindstorms prototype Video (https://www.youtube.com/watch?v=Wknbr2rZ5ZI)

Looked into non-linear control

Desire a single controller that works across all speeds.

Virtual Model Control

Energy-Balancing Control: Putting Energy Back in Control, R. Ortega et al.

Philip Salmony, Wolfson College | Self-Balancing Bike | November 22, 2018 | 7 / 12

## Progress - Controller Design (PD)

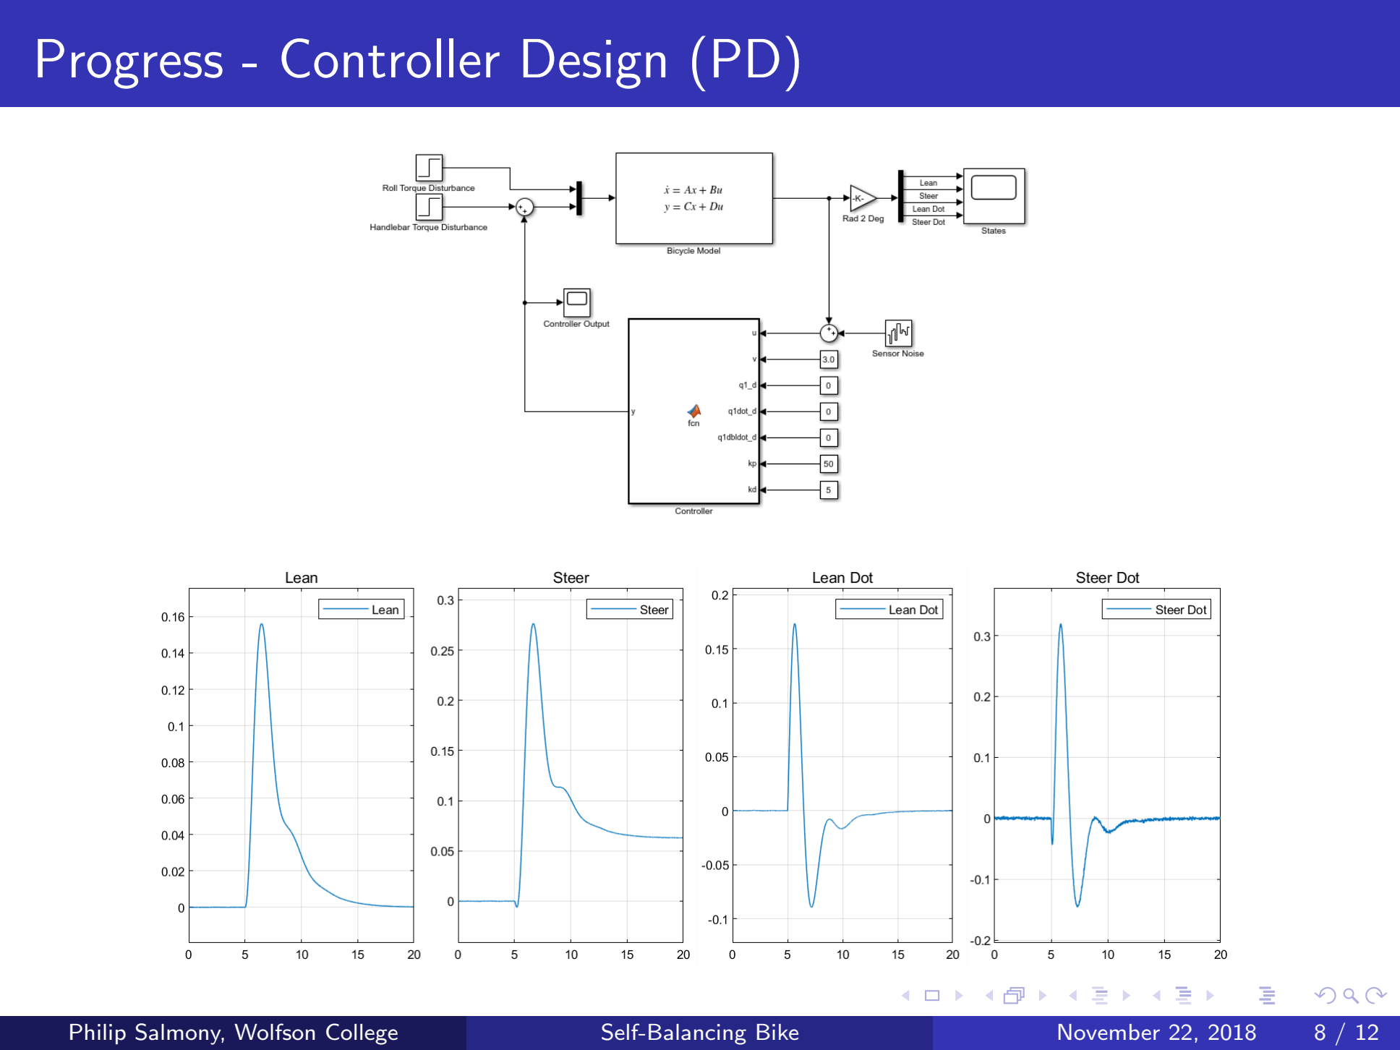
[picture p52: page 8]

Philip Salmony, Wolfson College | Self-Balancing Bike | November 22, 2018 | 8 / 12

## Findings So Far I

Modelling and Simulation

Non-linear model too hard to interpret intuitively. Stability strongly dependent on forward speed.
Difficult system: RHP poles and zeros
Linear Control

In theory, PD and LQR controllers can stabilise a rider-less bicycle.

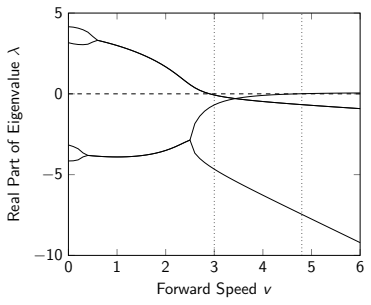
[picture p53: figure]
Forward Speed v; Real Part of Eigenvalue λ

Philip Salmony, Wolfson College | Self-Balancing Bike | November 22, 2018 | 9 / 12

## Findings So Far II

Non-linear Control

Virtual Model Control: need little knowledge about system, works in theory.
Energy-Balancing Control: finding re-shaping controller gets more and more difficult as system complexity increases.

Key Problems

Model identification
Real-world implementation

Full-scale Bike

A lot of work...
Sourcing components, mechanical design Scaling-up of controller design
Philip Salmony, Wolfson College | Self-Balancing Bike | November 22, 2018 | 10 / 12

## Plans

Michaelmas
Improve LEGO prototype.
Further investigate non-linear control.

Lent
H∞ loop shaping for robust control. Trajectory tracking.
Move on to full scale bike!

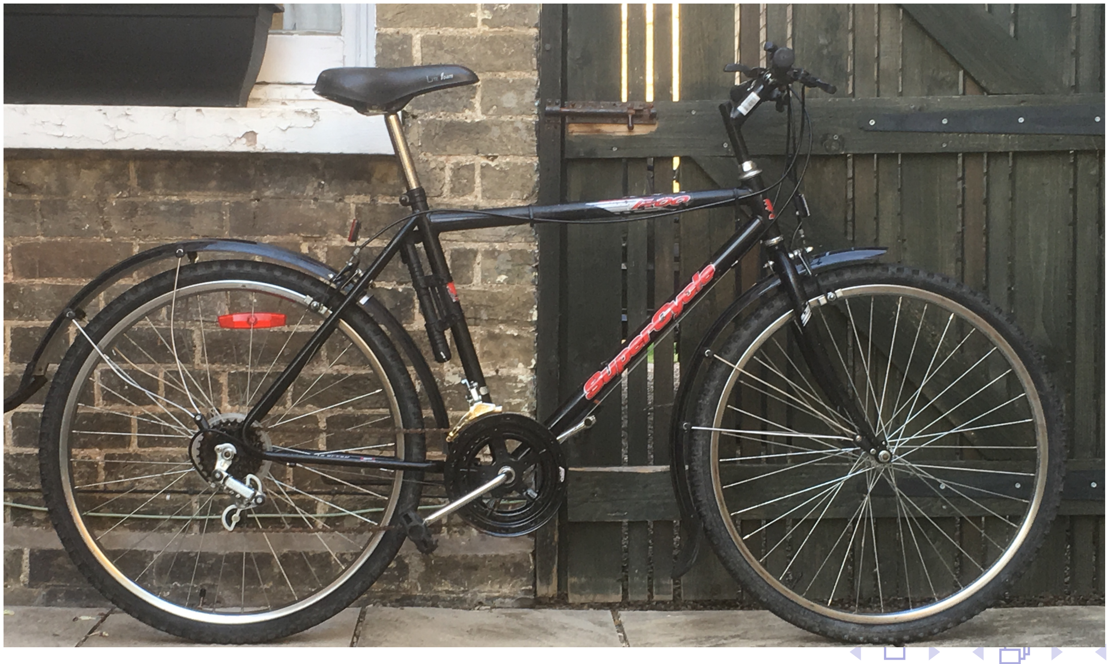
[picture p54: figure]

Philip Salmony, Wolfson College | Self-Balancing Bike | November 22, 2018 | 11 / 12

## Questions

# Thanks for listening!

# Any questions?

Philip Salmony, Wolfson College | Self-Balancing Bike | November 22, 2018 | 12 / 12
