Husseinbeygi/CUED-Self-Balancing-Bike/Reports/StabilityVsForwardSpeed.csv

v | a | b | c | d
0 | -4.155 | -3.1645 | 4.155 | 3.1645
0.1 | -4.1457 | -3.2613 | 4.1276 | 3.0963
0.2 | -4.0873 | -3.3994 | 4.0662 | 3.0544
0.3 | -3.9033 | -3.6551 | 3.9673 | 3.0419
0.4 | -3.811 | -3.811 | 3.8178 | 3.0719
0.5 | -3.8385 | -3.8385 | 3.5534 | 3.2083
0.6 | -3.8617 | -3.8617 | 3.3125 | 3.3125
0.7 | -3.8803 | -3.8803 | 3.2396 | 3.2396
0.8 | -3.8941 | -3.8941 | 3.1619 | 3.1619
0.9 | -3.9028 | -3.9028 | 3.0791 | 3.0791
1 | -3.9061 | -3.9061 | 2.9908 | 2.9908
1.1 | -3.9036 | -3.9036 | 2.8968 | 2.8968
1.2 | -3.8948 | -3.8948 | 2.7964 | 2.7964
1.3 | -3.8791 | -3.8791 | 2.6892 | 2.6892
1.4 | -3.8559 | -3.8559 | 2.5745 | 2.5745
1.5 | -3.8244 | -3.8244 | 2.4515 | 2.4515
1.6 | -3.7837 | -3.7837 | 2.3192 | 2.3192
1.7 | -3.7327 | -3.7327 | 2.1767 | 2.1767
1.8 | -3.6702 | -3.6702 | 2.0226 | 2.0226
1.9 | -3.5945 | -3.5945 | 1.8554 | 1.8554
2 | -3.5042 | -3.5042 | 1.6735 | 1.6735
2.1 | -3.3977 | -3.3977 | 1.4755 | 1.4755
2.2 | -3.2745 | -3.2745 | 1.2608 | 1.2608
2.3 | -3.1367 | -3.1367 | 1.0315 | 1.0315
2.4 | -2.993 | -2.993 | 0.7962 | 0.7962
2.5 | -2.86 | -2.86 | 0.57175 | 0.57175
2.6 | -3.6702 | -1.844 | 0.37728 | 0.37728
2.7 | -3.9997 | -1.3855 | 0.22128 | 0.22128
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
