Husseinbeygi/CUED-Self-Balancing-Bike/Basestation.png

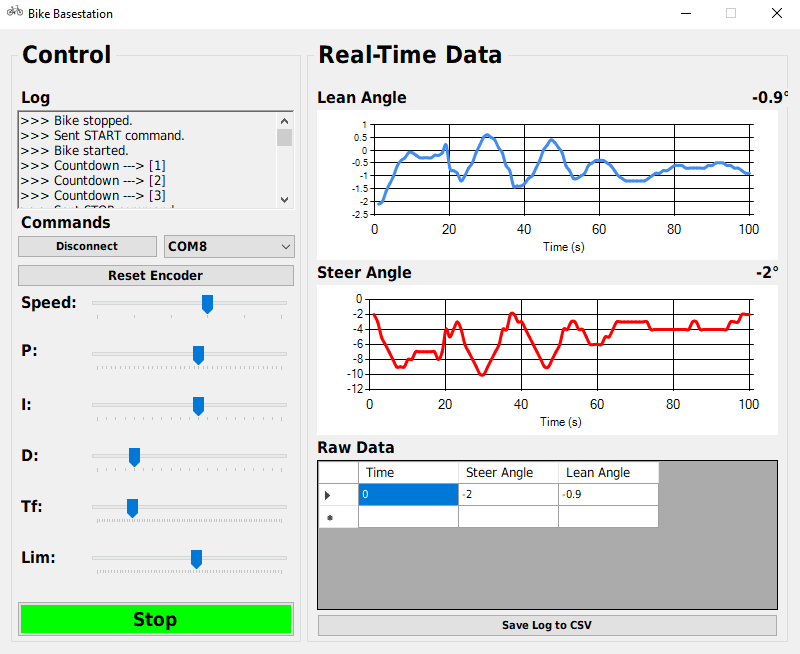
Basestation.png
