Husseinbeygi/CUED-Self-Balancing-Bike/Homework.JPG

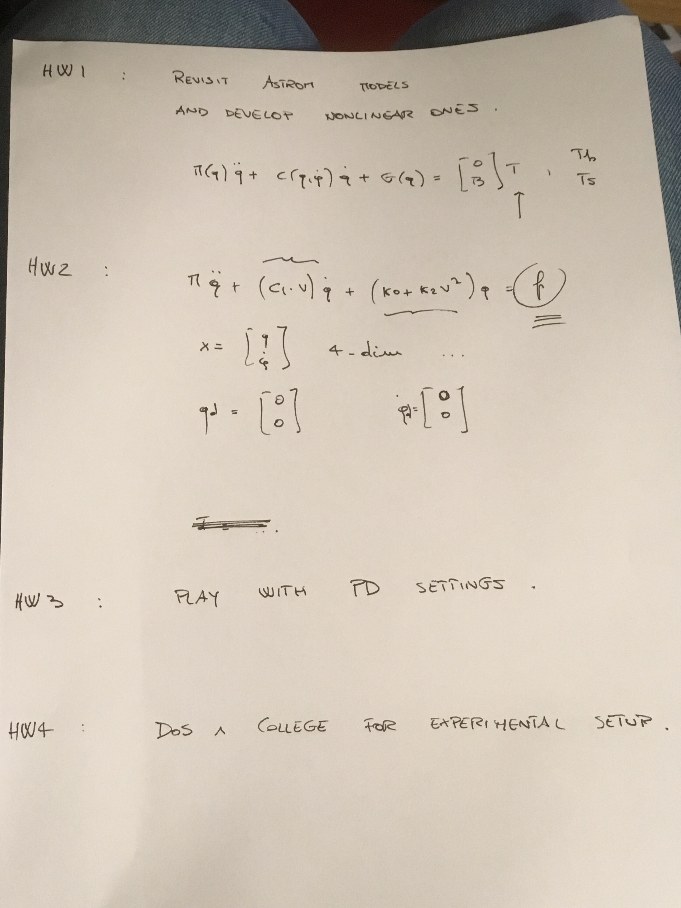
Homework.JPG
