Husseinbeygi/CUED-Self-Balancing-Bike/MatLAB Simulation/LegoServoIdentification.PNG

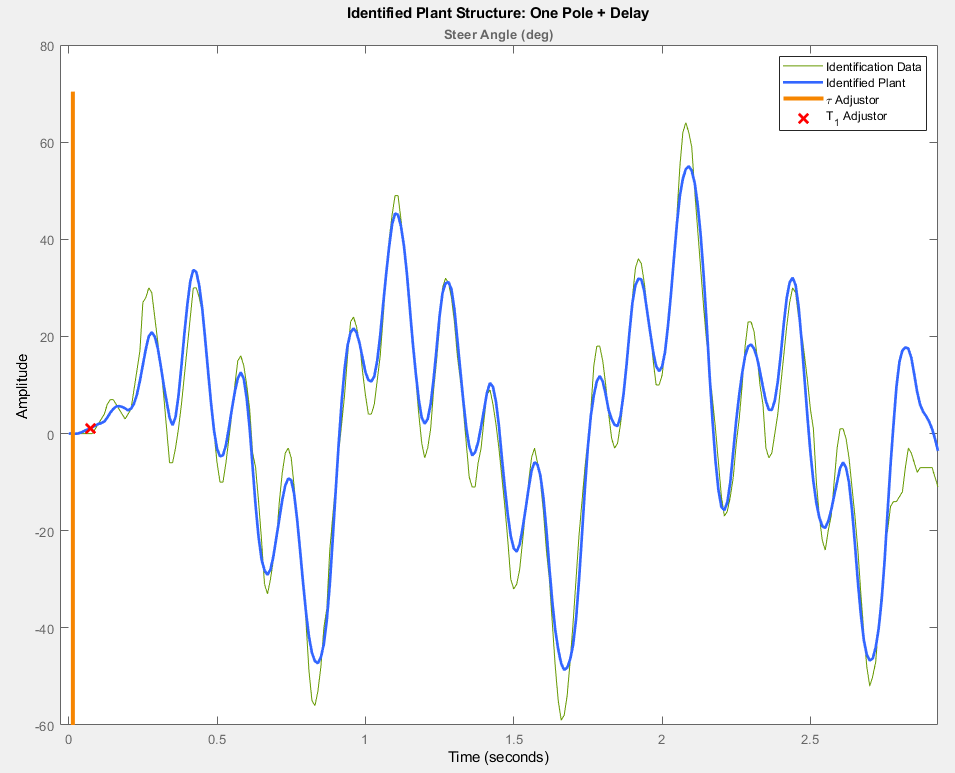
MatLAB Simulation/LegoServoIdentification.PNG
