Husseinbeygi/CUED-Self-Balancing-Bike/MatLAB Simulation/VMC Pendulum/SampleDisturbance.png

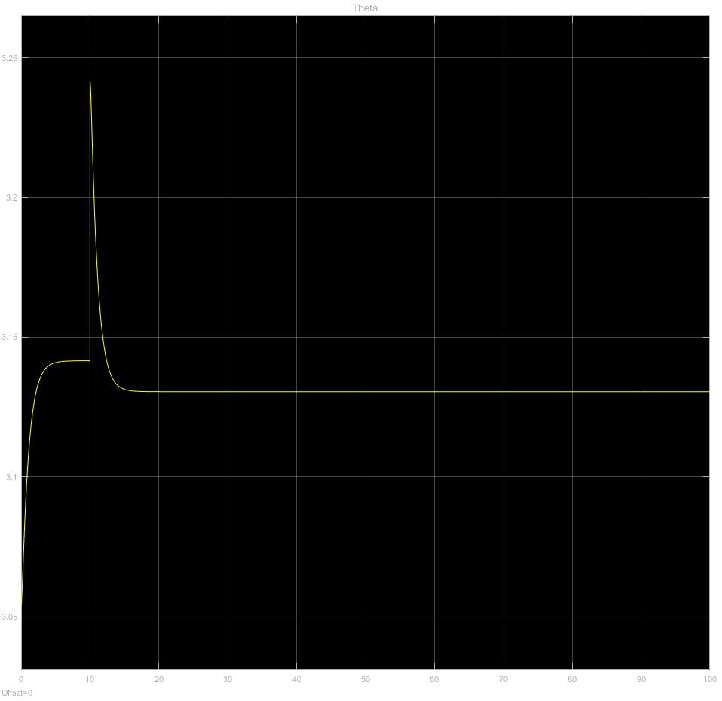
MatLAB Simulation/VMC Pendulum/SampleDisturbance.png
