Husseinbeygi/CUED-Self-Balancing-Bike/MatLAB Simulation/VMC Pendulum/SimulinkModel.PNG

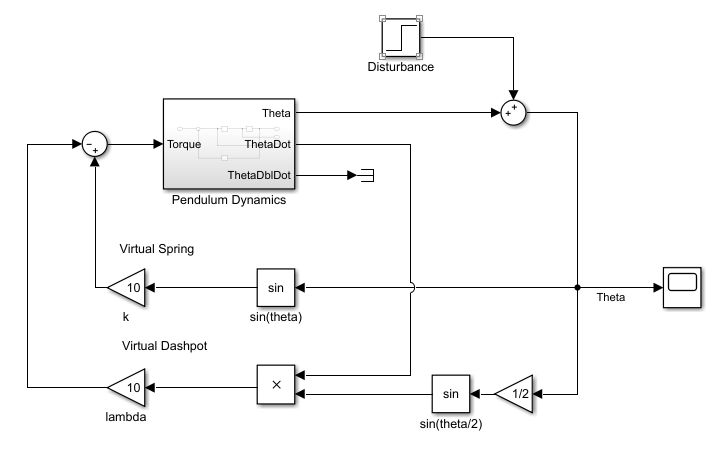
MatLAB Simulation/VMC Pendulum/SimulinkModel.PNG
