Husseinbeygi/CUED-Self-Balancing-Bike/Pictures/FSBikeMod.jpg

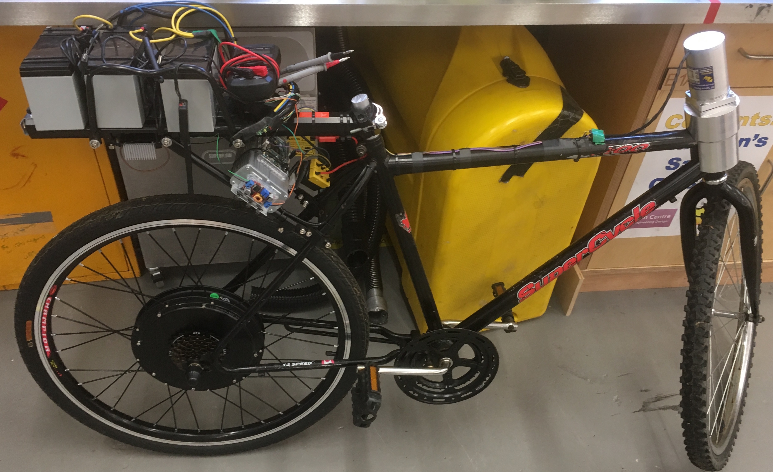
Pictures/FSBikeMod.jpg
