Husseinbeygi/CUED-Self-Balancing-Bike/Pictures/fsServoMount.JPG

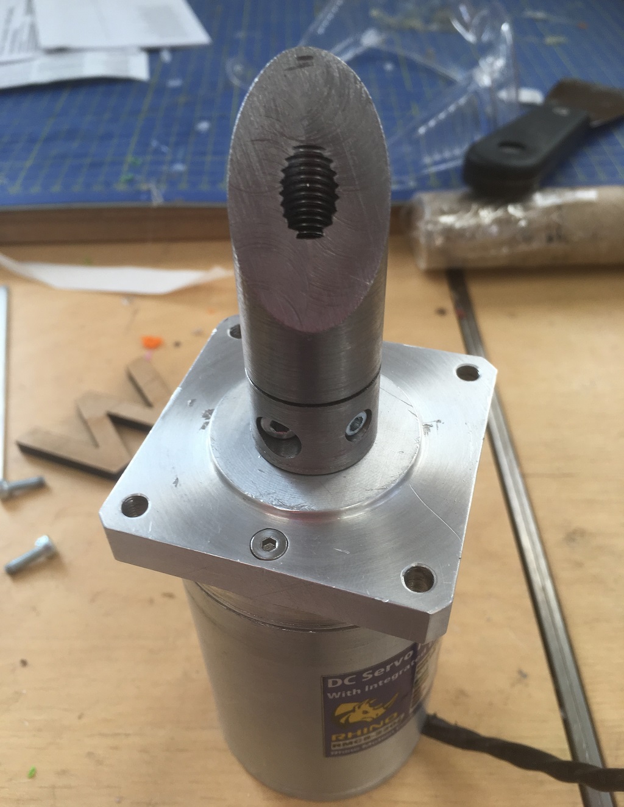
Pictures/fsServoMount.JPG
