Husseinbeygi/CUED-Self-Balancing-Bike/Pictures/IMG_2510.jpg

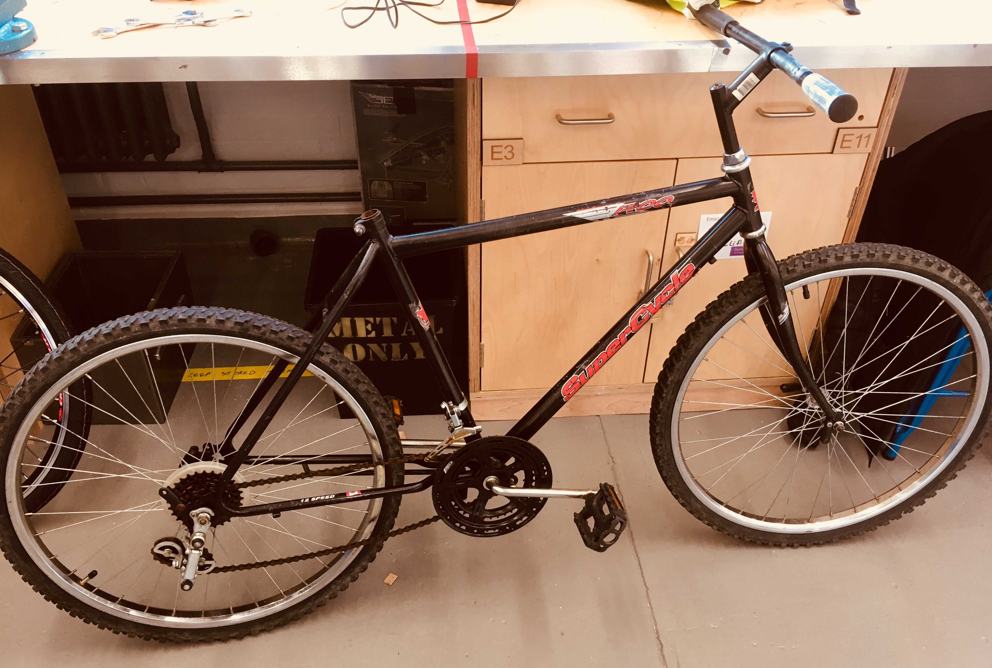
Pictures/IMG_2510.jpg
