Husseinbeygi/CUED-Self-Balancing-Bike/Pictures/IMG_2577.jpg

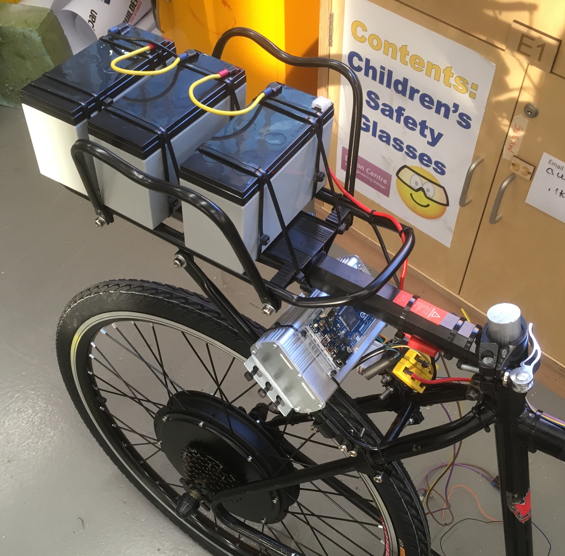
Pictures/IMG_2577.jpg
