Husseinbeygi/CUED-Self-Balancing-Bike/Pictures/IMG_2680.JPG

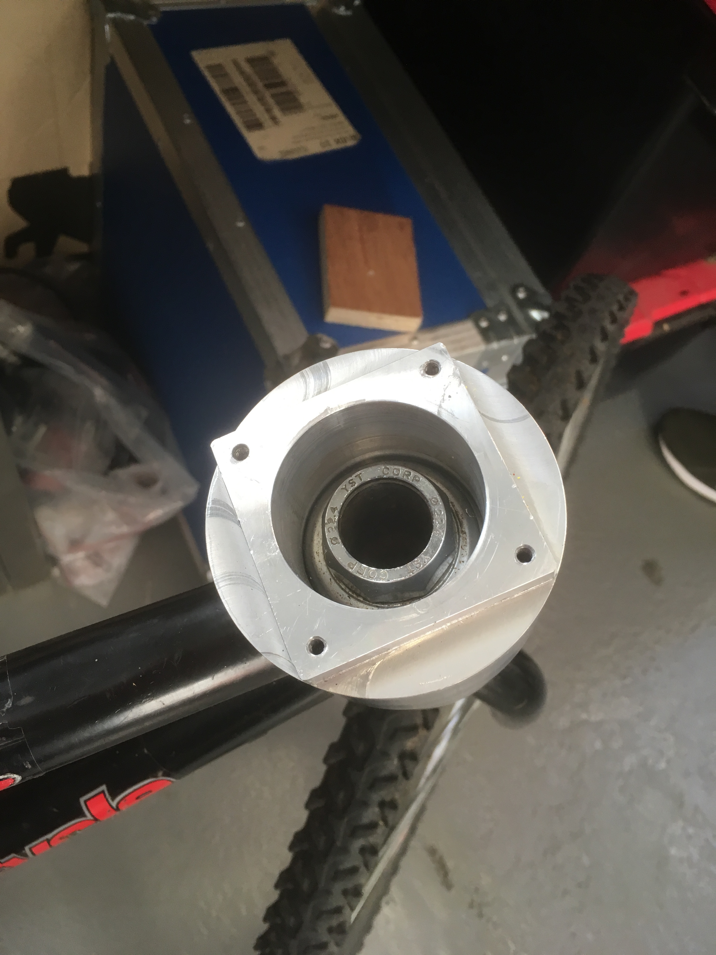
Pictures/IMG_2680.JPG
