Husseinbeygi/CUED-Self-Balancing-Bike/Presentation/Stability.png

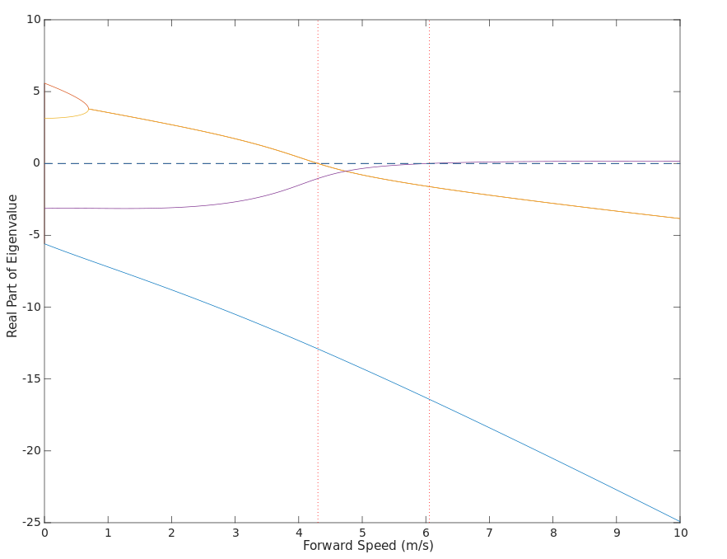
Presentation/Stability.png
