Husseinbeygi/CUED-Self-Balancing-Bike/Reports/Final Report/figures/Basestation.png

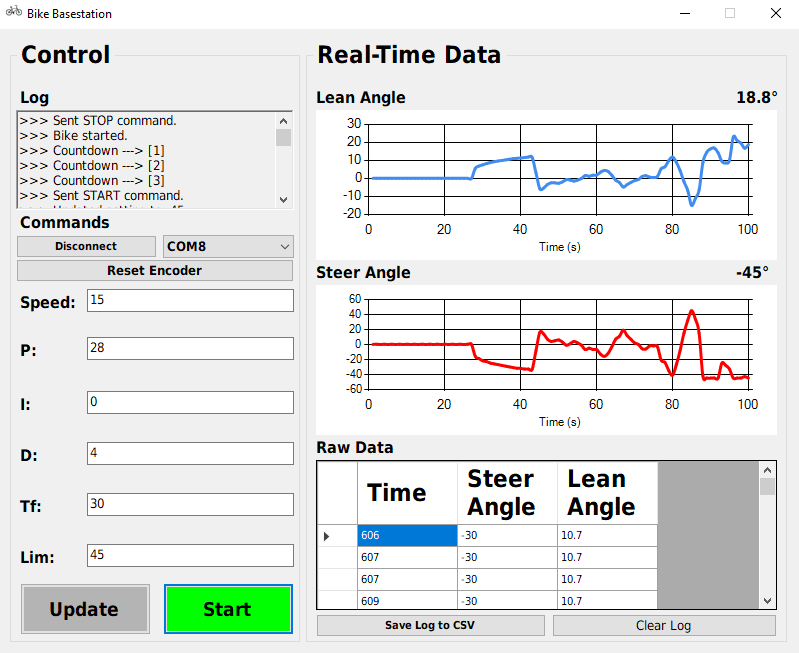
Reports/Final Report/figures/Basestation.png
