Husseinbeygi/CUED-Self-Balancing-Bike/Reports/StabilityVsForwardSpeed.png

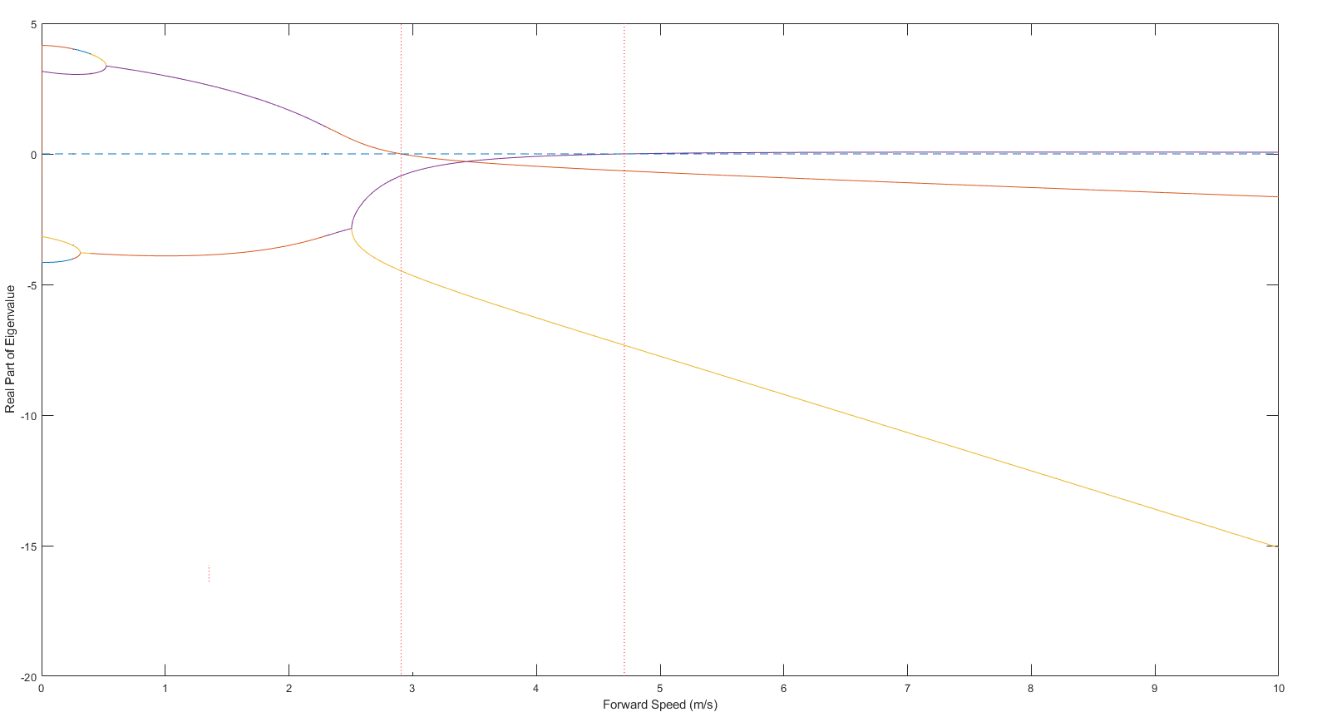
Reports/StabilityVsForwardSpeed.png
