Husseinbeygi/CUED-Self-Balancing-Bike/MatLAB Simulation/Energy Pendulum/SimulationResults (K=1,lambda=0.1).png

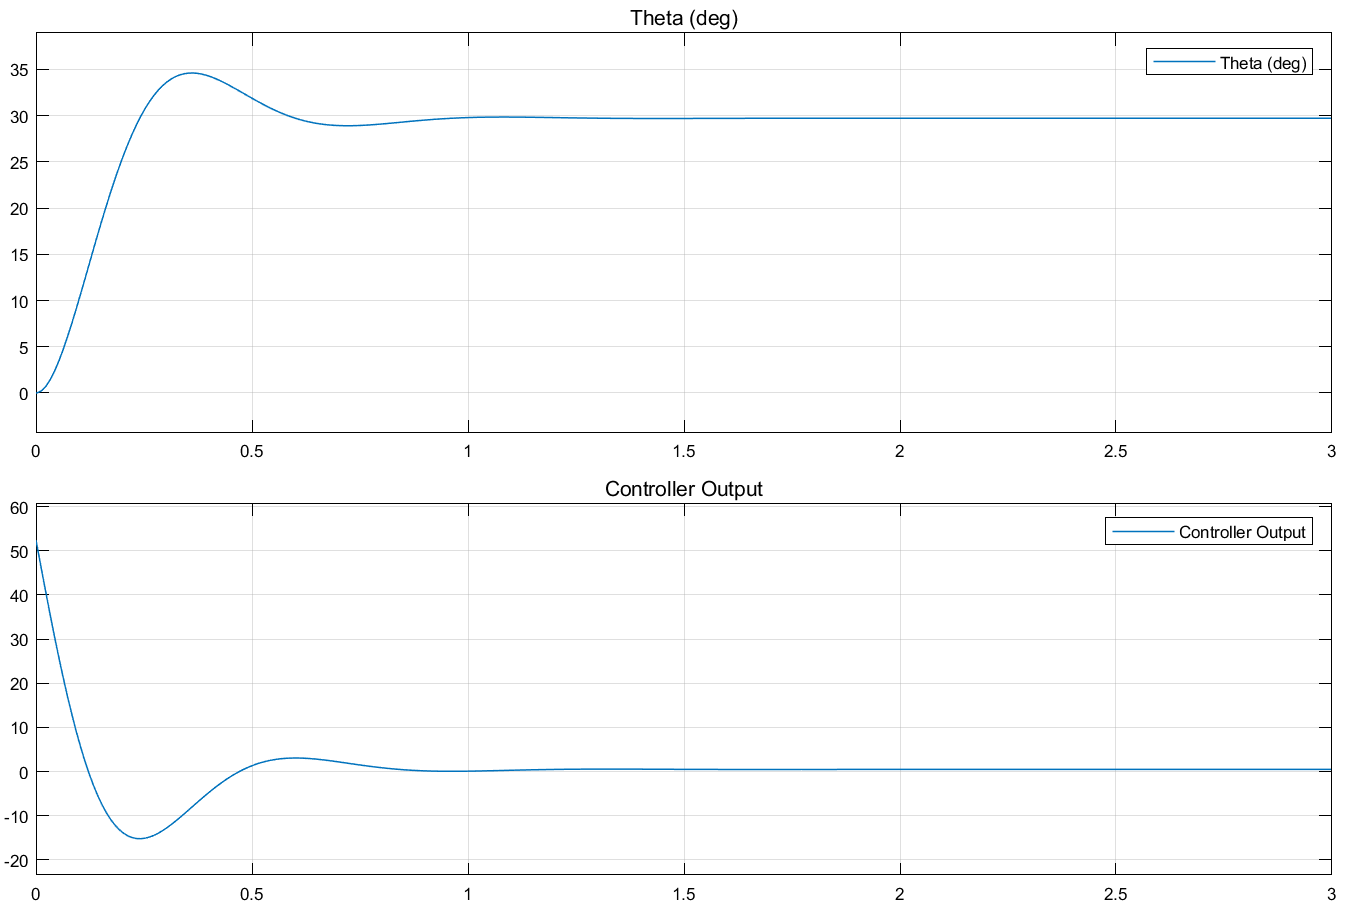
MatLAB Simulation/Energy Pendulum/SimulationResults (K=1,lambda=0.1).png
