Husseinbeygi/CUED-Self-Balancing-Bike/MatLAB Simulation/Energy Pendulum/SimulationResults Setpoint 180 Disturbance (K=1,lambda=0.1).png

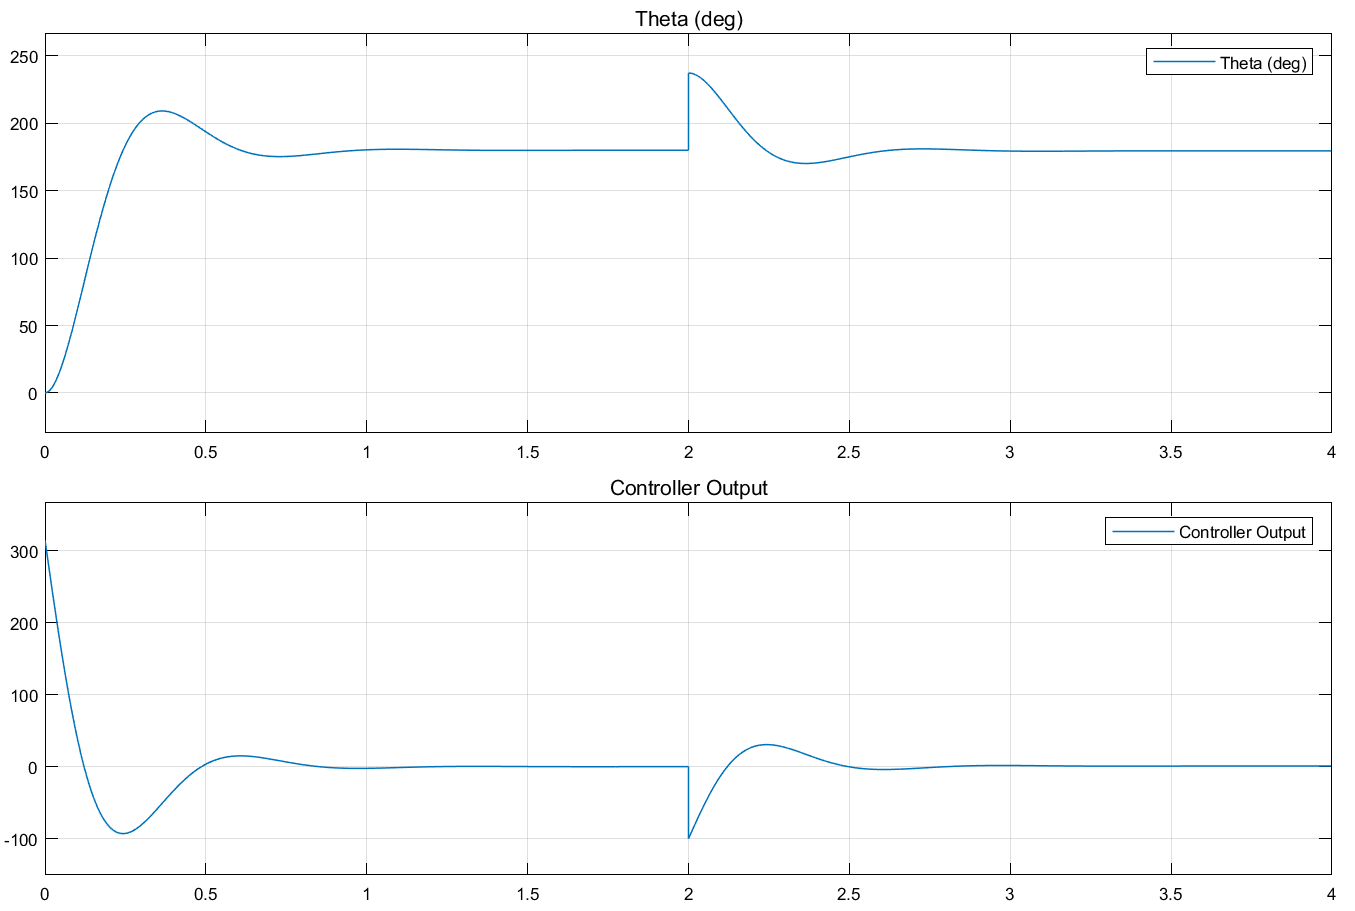
MatLAB Simulation/Energy Pendulum/SimulationResults Setpoint 180 Disturbance (K=1,lambda=0.1).png
