Husseinbeygi/CUED-Self-Balancing-Bike/MatLAB Simulation/VMC Pendulum/VMC Pendulum.pdf

## VirtualllodelControl PeadowI

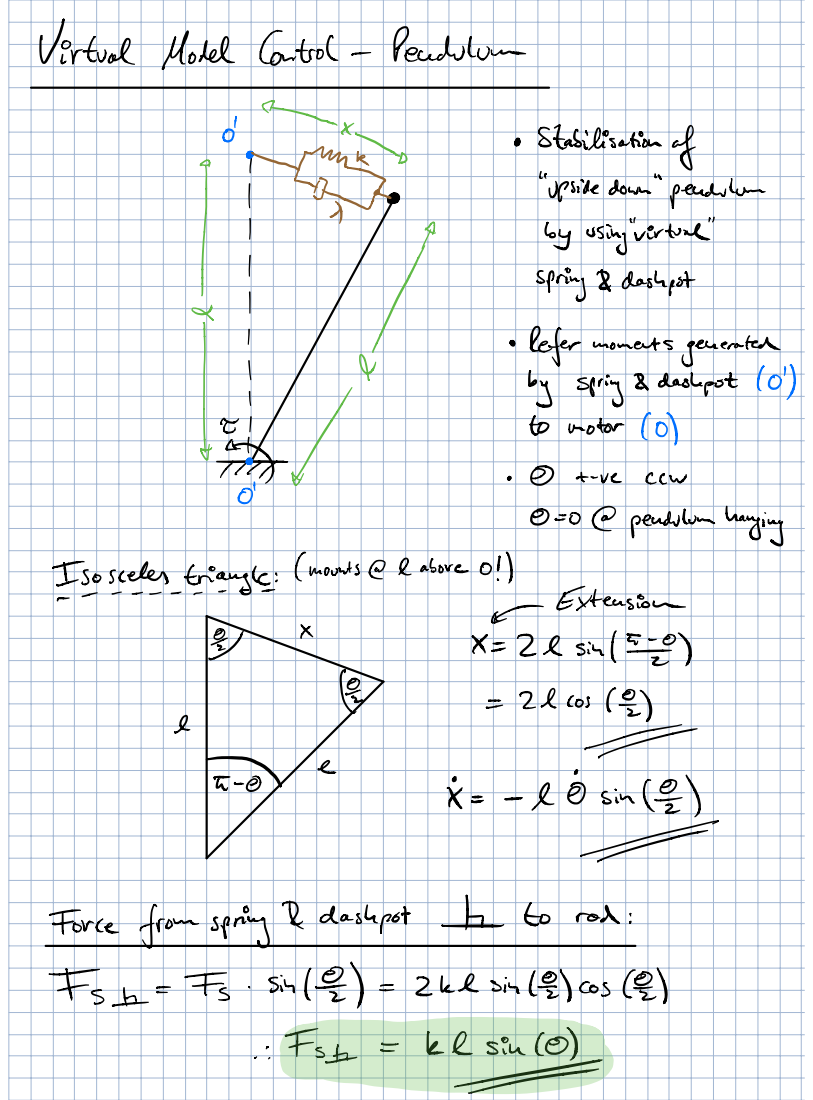
[picture p72: page 1]
Tmj; Stabilisationof; cos; since; Forcefronspragkdashpotorod; Sir; sin; Fst

1 | 4th | | upsidedown | pendulum

f | by using virtual

I | | spring21dashpot

I | | by Refer momentsgenerated l | spring | dashpot | O

E | | | | to | motor | | o
0,9

µ | O | t ve | Ccw

0 | 0 | pendulumhanging

IEoSfetf_EnaugfeCmouwts | | | | | lasore.o

Extension
X | 2lsin

| Fd | Xl | O | sin | E
E | Fs | Fat | l

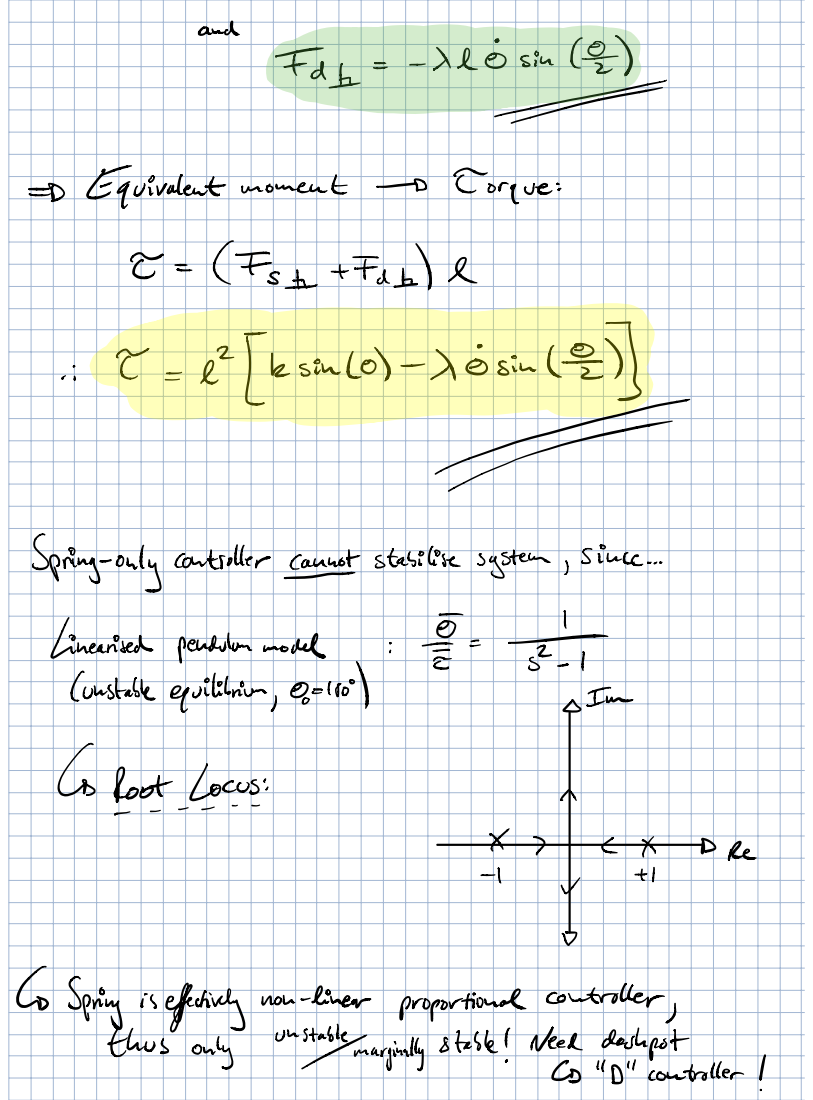
[picture p73: page 2]
Equivalent; moment; Torque; seu Lo; sin; Spring only controller canyot stabilise system; since; Linearised; pendulummodel; Constable; equilibrium; woo; G Root Locos; G Spring; is effectively; non; linear; proportional; controller; thus; only; marginally; stable; Need dashpot

and

## MatLABSimulation

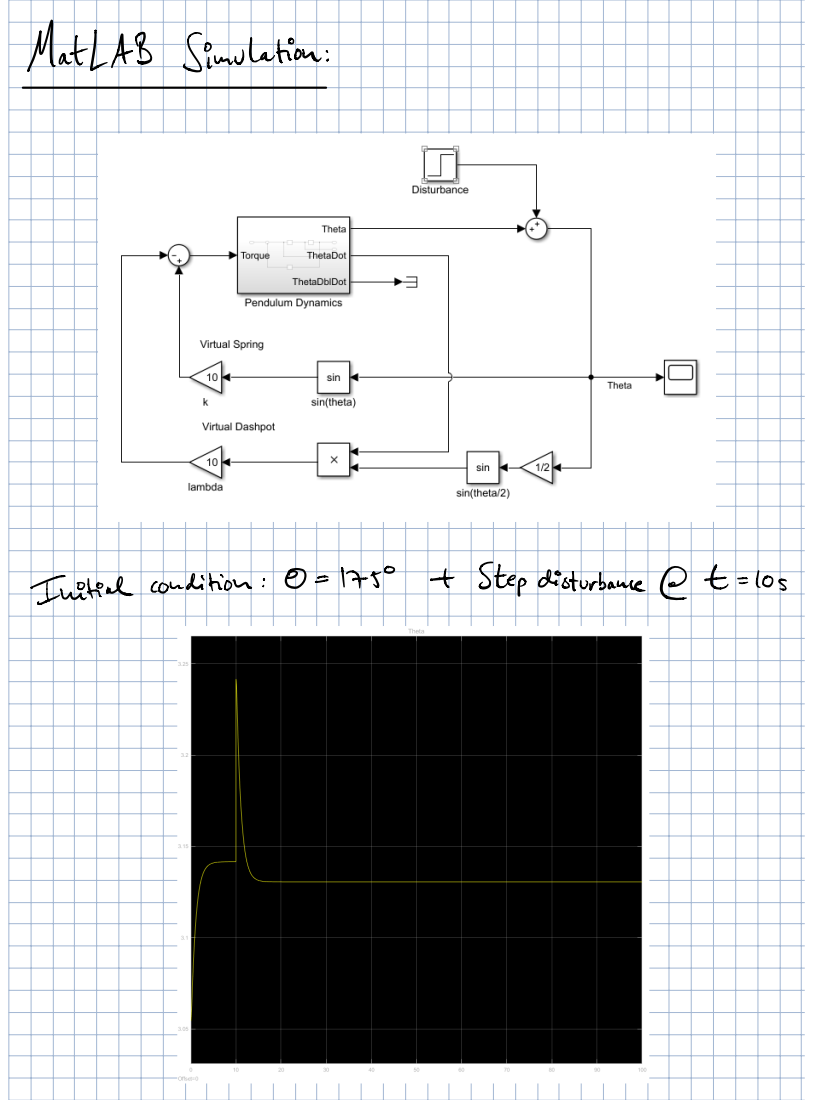
[picture p74: page 3]
Initial; condition; Step disturbance; Los
