Husseinbeygi/CUED-Self-Balancing-Bike/Reports/Final Report/figures/bikeevo.pdf

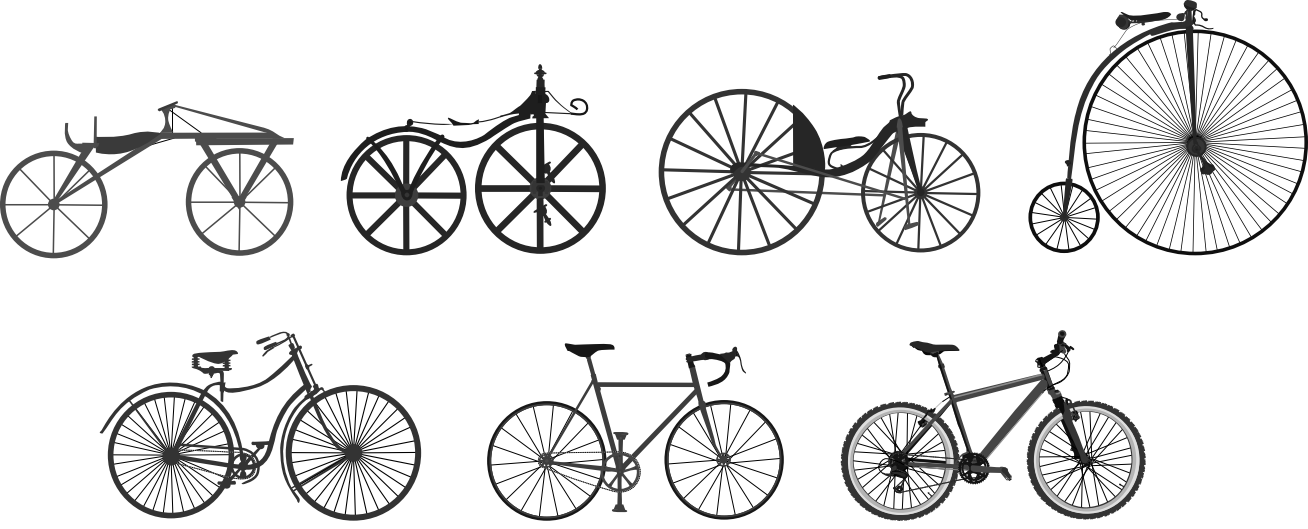
[picture p75: page 1]
