Husseinbeygi/CUED-Self-Balancing-Bike/Electrical/ConverterBoard/ConverterBoard.kicad_pcb

## KiCad design Electrical/ConverterBoard/ConverterBoard.kicad_pcb (2019-05-12)

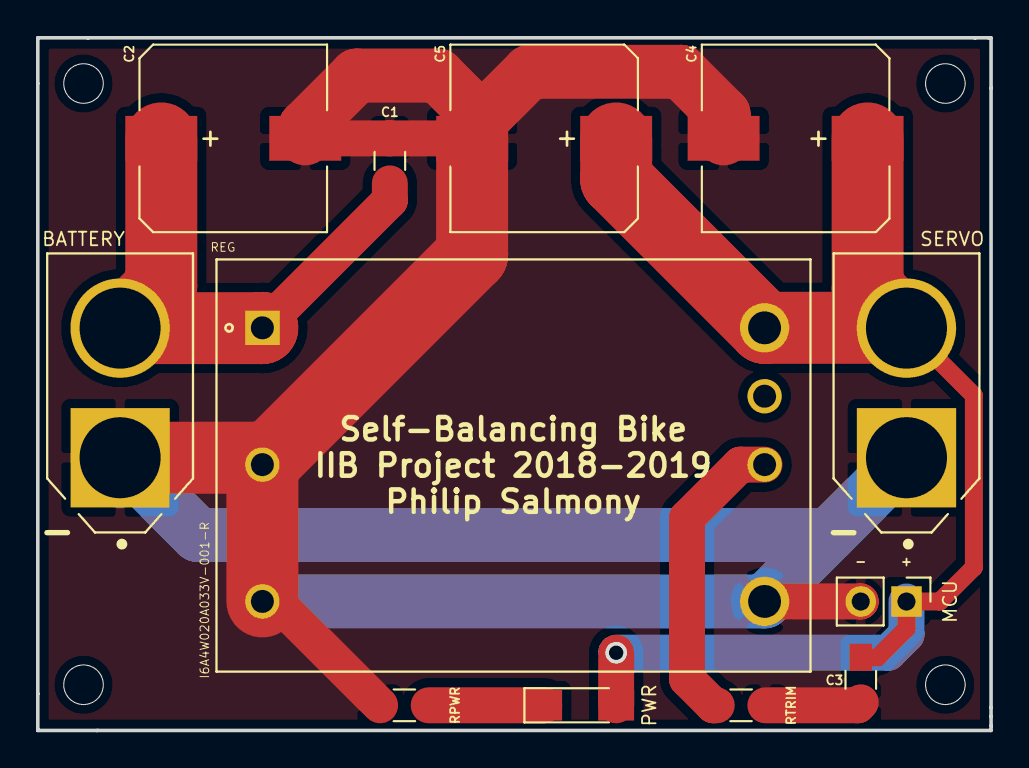
[picture p76: board ConverterBoard.kicad_pcb from above]

Board: 2 copper layers, 53.0 x 38.5 mm, 12 parts (0 on the bottom side), 5 nets.

Parts:
BATTERY: AMASS_XT60-M
C1, C3: C_0805_HandSoldering
C2, C4, C5: CP_Elec_10x10
MCU: Pin_Header_Straight_1x02_Pitch2.54mm
PWR: LED_1206_HandSoldering
REG: I6A4W020A033V-001-R; TDK-LAMBDA_I6A4W020A033V-001-R
RPWR: R_0805_HandSoldering
RTRIM: R_0805_HandSoldering
SERVO: AMASS_XT60-M

Connections:
+12V: C3.1, C4.1, C5.1, MCU.1, PWR.2, REG.8, SERVO.2
GND: BATTERY.1, C1.2, C2.2, C3.2, C4.2, C5.2, MCU.2, REG.2, REG.3, REG.4, RPWR.1, RTRIM.1, SERVO.1
unnamed: PWR.1, RPWR.2
unnamed: REG.6, RTRIM.2
VCC: BATTERY.2, C1.1, C2.1, REG.1
