Husseinbeygi/CUED-Self-Balancing-Bike/Electrical/TeensyBikeShield/TeensyBikeShield.kicad_pcb

## KiCad design Electrical/TeensyBikeShield/TeensyBikeShield.kicad_pcb (2019-05-12)

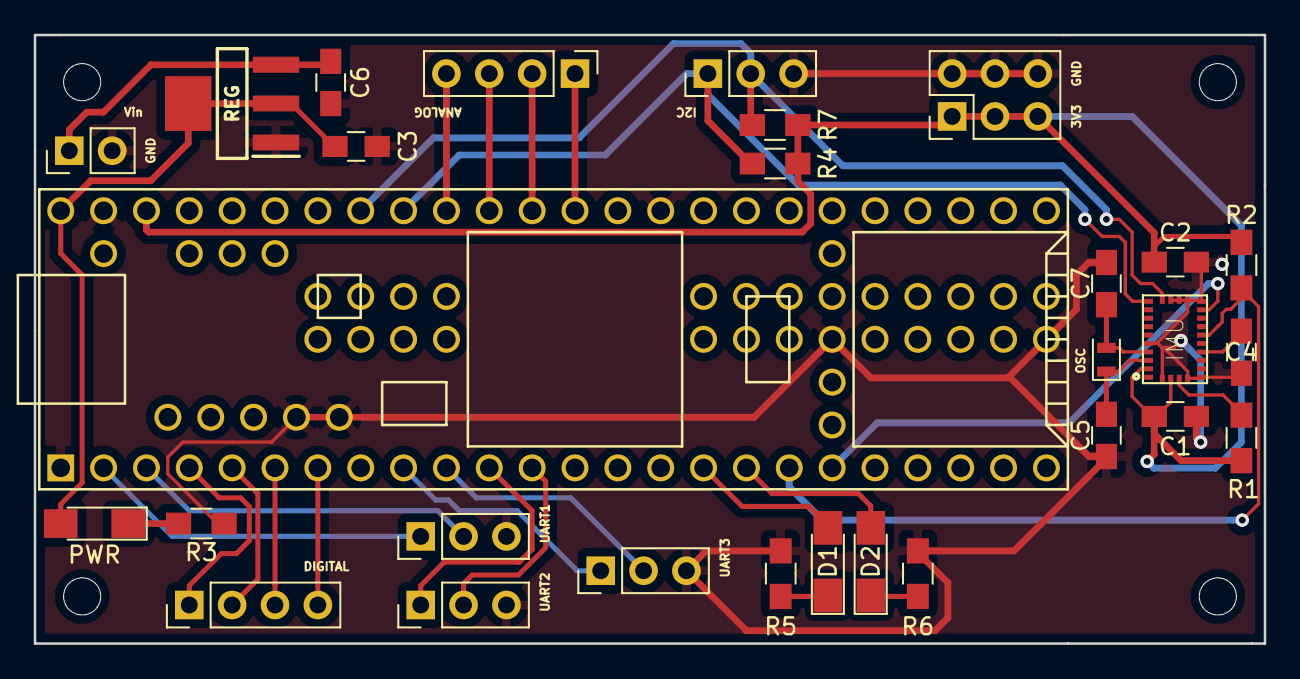
[picture p77: board TeensyBikeShield.kicad_pcb from above]

Board: 2 copper layers, 72.9 x 36.1 mm, 27 parts (0 on the bottom side), 14 nets.

Parts:
ANALOG: Pin_Header_Straight_1x04_Pitch2.54mm
C1, C2, C3, C4, C5, C6, C7: C_0805_HandSoldering
D1, D2: LED_1206_HandSoldering
DIGITAL: Pin_Header_Straight_1x04_Pitch2.54mm
I2C: Pin_Header_Straight_1x03_Pitch2.54mm
IMU: LGA28R50P4X10_380X520X100
OSC: Crystal_SMD_2012-2pin_2.0x1.2mm
PWR: LED_1206_HandSoldering
R1, R2, R3, R4, R5, R6, R7: R_0805_HandSoldering
REG: LDL1117S50R; SOT230P700X180-4N
UART1, UART2, UART3: Pin_Header_Straight_1x03_Pitch2.54mm
Vin: Pin_Header_Straight_1x02_Pitch2.54mm

Connections:
+3V3: C1.1, C2.1, IMU.3, IMU.28, R1.2, R2.2, R4.2, R7.2
+5V: C3.1, PWR.2, REG.2, REG.4
/I2C_SCL: I2C.2, IMU.19, R7.1
/I2C_SDA: I2C.1, IMU.20, R4.1
/IMU_RESET: IMU.11, R2.1
/XIN32: C5.1, IMU.27, OSC.1
/XOUT32: C7.1, IMU.26, OSC.2
GND: C1.2, C2.2, C3.2, C4.2, C5.2, C6.2, C7.2, I2C.3, IMU.2, IMU.5, IMU.6, IMU.15, IMU.16, IMU.17, IMU.18, IMU.25, R3.1, R5.1, R6.1, REG.1, UART1.3, UART2.3, UART3.3, Vin.2
unnamed: C4.1, IMU.9
unnamed: D1.1, R5.2
unnamed: D2.1, R6.2
unnamed: IMU.4, R1.1
unnamed: PWR.1, R3.2
VCC: C6.1, REG.3, Vin.1
