Husseinbeygi/CUED-Self-Balancing-Bike/Big Bike/Arduino/MPU9250Test/MPU9250Test.ino

#include "MPU9250.h"

void setup()
{
  Wire.begin();
  Serial.begin(115200);

  pinMode(intPin, INPUT);
  digitalWrite(intPin, LOW);
  pinMode(myLed, OUTPUT);
  digitalWrite(myLed, HIGH);


  byte c = readByte(MPU9250_ADDRESS, WHO_AM_I_MPU9250);  // Read WHO_AM_I register for MPU-9250
  delay(1000);

  if (c == 0x71) // WHO_AM_I should always be 0x68
  {
    Serial.println("MPU9250 is online...");

    MPU9250SelfTest(SelfTest); // Start by performing self test and reporting values
    Serial.print("x-axis self test: acceleration trim within : "); Serial.print(SelfTest[0], 1); Serial.println("% of factory value");
    Serial.print("y-axis self test: acceleration trim within : "); Serial.print(SelfTest[1], 1); Serial.println("% of factory value");
    Serial.print("z-axis self test: acceleration trim within : "); Serial.print(SelfTest[2], 1); Serial.println("% of factory value");
    Serial.print("x-axis self test: gyration trim within : "); Serial.print(SelfTest[3], 1); Serial.println("% of factory value");
    Serial.print("y-axis self test: gyration trim within : "); Serial.print(SelfTest[4], 1); Serial.println("% of factory value");
    Serial.print("z-axis self test: gyration trim within : "); Serial.print(SelfTest[5], 1); Serial.println("% of factory value");

    calibrateMPU9250(gyroBias, accelBias); // Calibrate gyro and accelerometers, load biases in bias registers
    delay(1000);

    initMPU9250();
    Serial.println("MPU9250 initialized for active data mode...."); // Initialize device for active mode read of acclerometer, gyroscope, and temperature

    // Read the WHO_AM_I register of the magnetometer, this is a good test of communication
    byte d = readByte(AK8963_ADDRESS, AK8963_WHO_AM_I);  // Read WHO_AM_I register for AK8963
    Serial.print("AK8963 "); Serial.print("I AM "); Serial.print(d, HEX); Serial.print(" I should be "); Serial.println(0x48, HEX);

    delay(1000);

    // Get magnetometer calibration from AK8963 ROM
    initAK8963(magCalibration); Serial.println("AK8963 initialized for active data mode...."); // Initialize device for active mode read of magnetometer

    if (SerialDebug) {
      //  Serial.println("Calibration values: ");
      Serial.print("X-Axis sensitivity adjustment value "); Serial.println(magCalibration[0], 2);
      Serial.print("Y-Axis sensitivity adjustment value "); Serial.println(magCalibration[1], 2);
      Serial.print("Z-Axis sensitivity adjustment value "); Serial.println(magCalibration[2], 2);
    }


  }
  else
  {
    Serial.print("Could not connect to MPU9250: 0x");
    Serial.println(c, HEX);
    while (1) ; // Loop forever if communication doesn't happen
  }
}

void loop()
{
  // If intPin goes high, all data registers have new data
  if (readByte(MPU9250_ADDRESS, INT_STATUS) & 0x01) {  // On interrupt, check if data ready interrupt
    readAccelData(accelCount);  // Read the x/y/z adc values
    getAres();

    // Now we'll calculate the accleration value into actual g's
    ax = (float)accelCount[0] * aRes; // - accelBias[0];  // get actual g value, this depends on scale being set
    ay = (float)accelCount[1] * aRes; // - accelBias[1];
    az = (float)accelCount[2] * aRes; // - accelBias[2];

    readGyroData(gyroCount);  // Read the x/y/z adc values
    getGres();

    // Calculate the gyro value into actual degrees per second
    gx = (float)gyroCount[0] * gRes; // get actual gyro value, this depends on scale being set
    gy = (float)gyroCount[1] * gRes;
    gz = (float)gyroCount[2] * gRes;

    readMagData(magCount);  // Read the x/y/z adc values
    getMres();
    magbias[0] = +470.;  // User environmental x-axis correction in milliGauss, should be automatically calculated
    magbias[1] = +120.;  // User environmental x-axis correction in milliGauss
    magbias[2] = +125.;  // User environmental x-axis correction in milliGauss

    // Calculate the magnetometer values in milliGauss
    // Include factory calibration per data sheet and user environmental corrections
    mx = (float)magCount[0] * mRes * magCalibration[0] - magbias[0]; // get actual magnetometer value, this depends on scale being set
    my = (float)magCount[1] * mRes * magCalibration[1] - magbias[1];
    mz = (float)magCount[2] * mRes * magCalibration[2] - magbias[2];
  }

  Now = micros();
  deltat = ((Now - lastUpdate) / 1000000.0f); // set integration time by time elapsed since last filter update
  lastUpdate = Now;

  sum += deltat; // sum for averaging filter update rate
  sumCount++;

  //  MadgwickQuaternionUpdate(ax, ay, az, gx*PI/180.0f, gy*PI/180.0f, gz*PI/180.0f,  my,  mx, mz);
  MahonyAHRSupdate(ax, ay, az, gx * PI / 180.0f, gy * PI / 180.0f, gz * PI / 180.0f, my, mx, mz);


  // Serial print and/or display at 0.5 s rate independent of data rates
  delt_t = millis() - count;
  if (delt_t > 500) { // update LCD once per half-second independent of read rate

    if (SerialDebug) {
      Serial.print("ax = "); Serial.print((int)1000 * ax);
      Serial.print(" ay = "); Serial.print((int)1000 * ay);
      Serial.print(" az = "); Serial.print((int)1000 * az); Serial.println(" mg");
      Serial.print("gx = "); Serial.print( gx, 2);
      Serial.print(" gy = "); Serial.print( gy, 2);
      Serial.print(" gz = "); Serial.print( gz, 2); Serial.println(" deg/s");
      Serial.print("mx = "); Serial.print( (int)mx );
      Serial.print(" my = "); Serial.print( (int)my );
      Serial.print(" mz = "); Serial.print( (int)mz ); Serial.println(" mG");

      Serial.print("q0 = "); Serial.print(q[0]);
      Serial.print(" qx = "); Serial.print(q[1]);
      Serial.print(" qy = "); Serial.print(q[2]);
      Serial.print(" qz = "); Serial.println(q[3]);
    }

    yaw   = atan2(2.0f * (q[1] * q[2] + q[0] * q[3]), q[0] * q[0] + q[1] * q[1] - q[2] * q[2] - q[3] * q[3]);
    pitch = -asin(2.0f * (q[1] * q[3] - q[0] * q[2]));
    roll  = atan2(2.0f * (q[0] * q[1] + q[2] * q[3]), q[0] * q[0] - q[1] * q[1] - q[2] * q[2] + q[3] * q[3]);
    pitch *= 180.0f / PI;
    yaw   *= 180.0f / PI;
    yaw   -= 0.283; // Declination in Cambridge
    roll  *= 180.0f / PI;

    if (SerialDebug) {
      Serial.print("Yaw, Pitch, Roll: ");
      Serial.print(yaw, 2);
      Serial.print(", ");
      Serial.print(pitch, 2);
      Serial.print(", ");
      Serial.println(roll, 2);

      Serial.print("rate = "); Serial.print((float)sumCount / sum, 2); Serial.println(" Hz");
    }


    count = millis();
    sumCount = 0;
    sum = 0;
  }
}
