Husseinbeygi/CUED-Self-Balancing-Bike/(commit log)

2019-05-21 Wrote a bit more...
    [P12I30D03TAU0003.csv, P12I38D044TAU000062.csv, P1I30D03TAU0003.csv, legoKalman.csv, pLego.csv, pidLego.csv]
2019-05-21 And even more...
    [FSServoData.csv, legoBode.csv, legoBodeShaped.csv, legoHinf.csv, legoHinfResp.csv, legoPID.csv, legoServoData.csv, legoServoVerification.csv]
2019-05-21 Next revision.
    [fsHinfSim.csv, fsPIDSim.csv, legoPIDImp.csv, legoPZ.csv]
2019-05-22 Started on section FS implementation.
    [fsHinfSim.csv, fsLQRSim.csv, fsPIDSim.csv, legoHInfReal.csv, lqrLego.csv]
2019-05-27 FS and abstract.
    [1.csv, P15.csv, fsP1point5.csv, fsPID.csv, p25i0d4tf30.csv]
